Blue-Smoke-Electronics/Ember/README.md

# Ember, a Portable "Bench top" Power supply

Go to [the wiki](https://github.com/simenhs/Blue_Smoke_Portable_benchtop_supply/wiki) for documentation
