Blue-Smoke-Electronics/Ember/encosure/accessories/Cover.stl

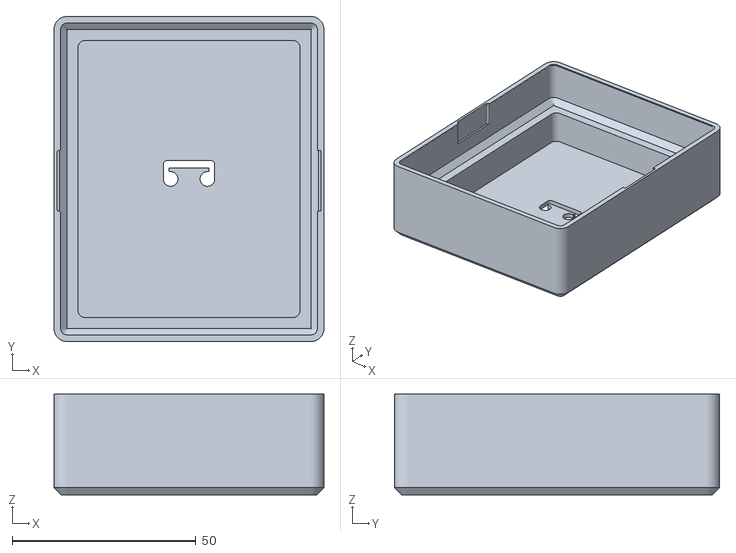
[picture p1: CAD file, 2023-03-30]
encosure/accessories/Cover.stl
73.5 x 88.5 x 27.5
