Blue-Smoke-Electronics/Ember/encosure/Frontpanel_no_ears.stl

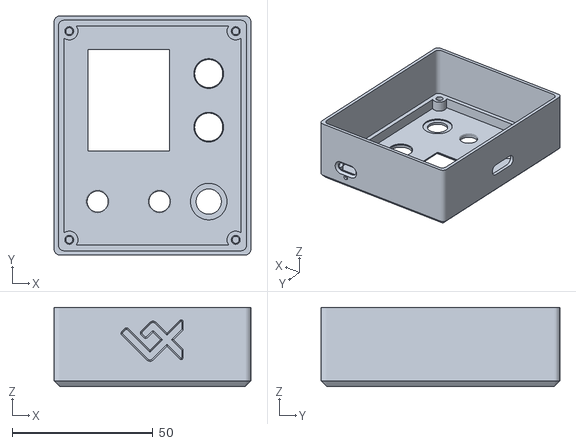
[picture p2: CAD file, 2023-10-11]
encosure/Frontpanel_no_ears.stl
70.0 x 85.0 x 28.2
