Blue-Smoke-Electronics/Ember/encosure/accessories/Cover_rev7_8_9.stl

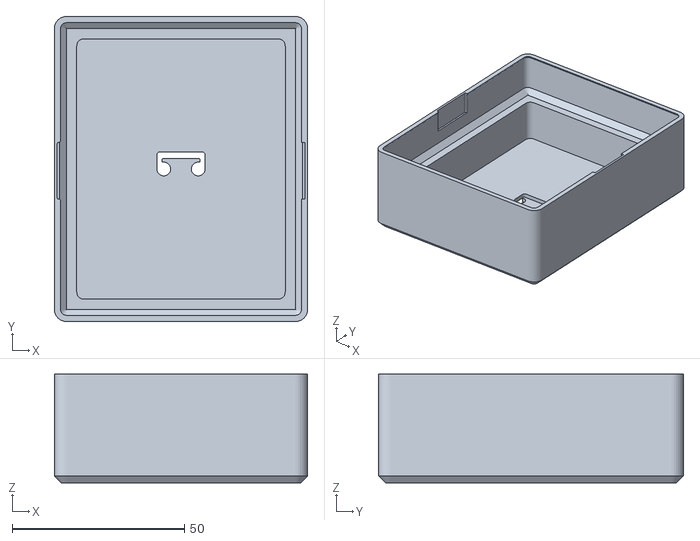
[picture p3: CAD file, 2023-03-30]
encosure/accessories/Cover_rev7_8_9.stl
73.5 x 88.5 x 31.5
