Blue-Smoke-Electronics/Ember/encosure/display_holder.stl

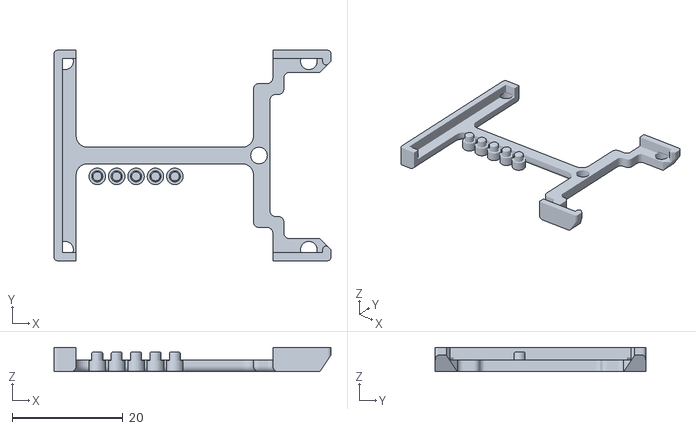
[picture p4: CAD file, 2023-09-27]
encosure/display_holder.stl
50.0 x 38.0 x 4.42
