Blue-Smoke-Electronics/Ember/encosure/Bottom_lid.stl

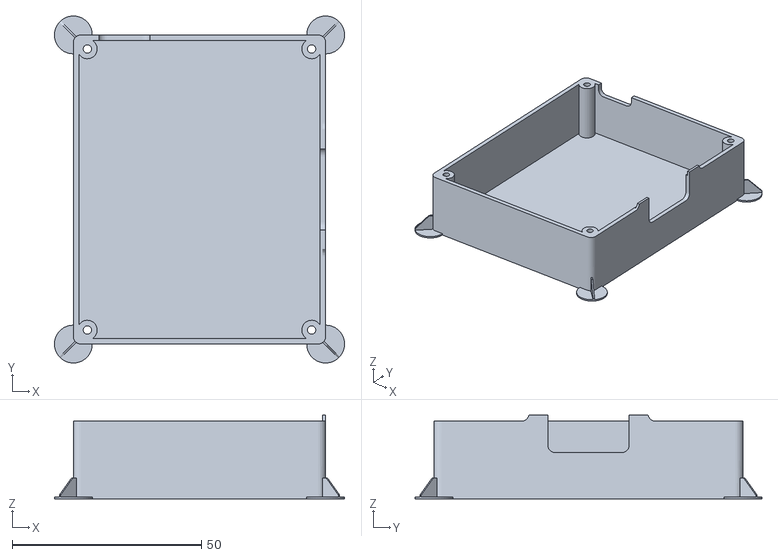
[picture p5: CAD file, 2023-03-14]
encosure/Bottom_lid.stl
76.6 x 91.6 x 22.1
