Blue-Smoke-Electronics/Ember/encosure/encoder_knob_custom.stl

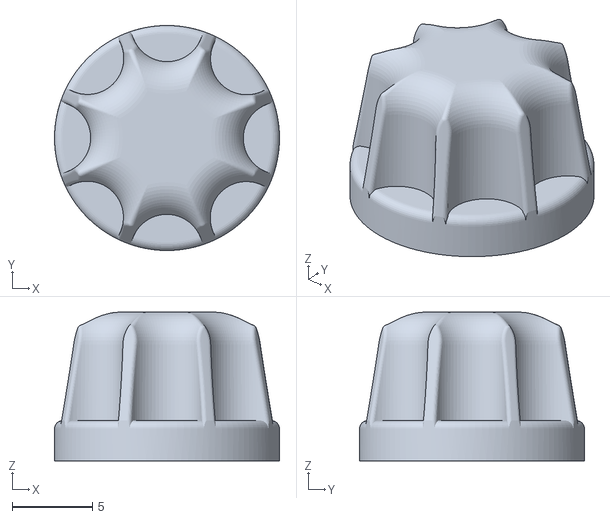
[picture p6: CAD file, 2023-02-27]
encosure/encoder_knob_custom.stl
14.0 x 14.0 x 9.25
