Blue-Smoke-Electronics/Ember/encosure/Frontpanel.stl

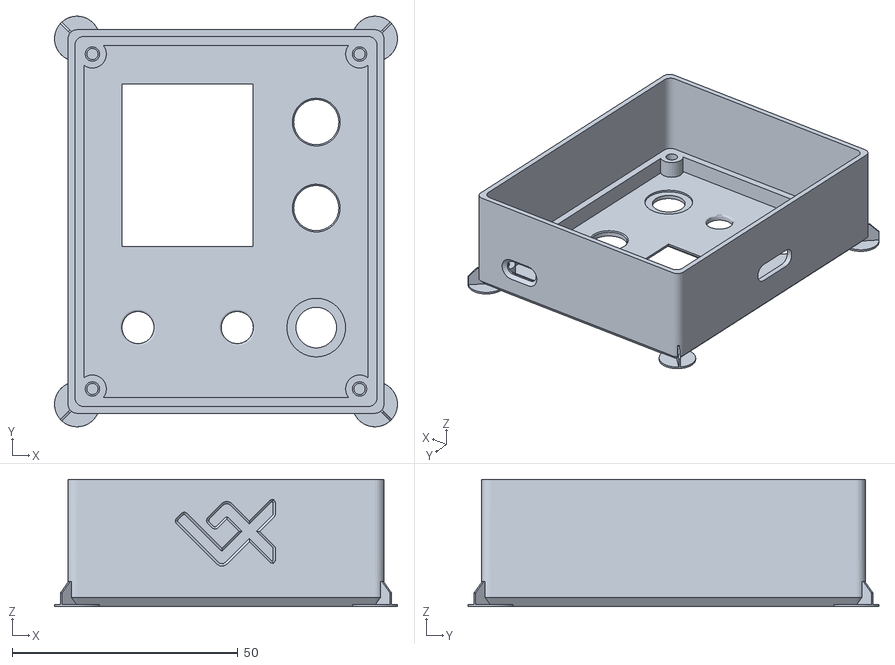
[picture p7: CAD file, 2023-02-19]
encosure/Frontpanel.stl
76.0 x 91.0 x 28.2
