Blue-Smoke-Electronics/Ember/encosure/power_button.stl

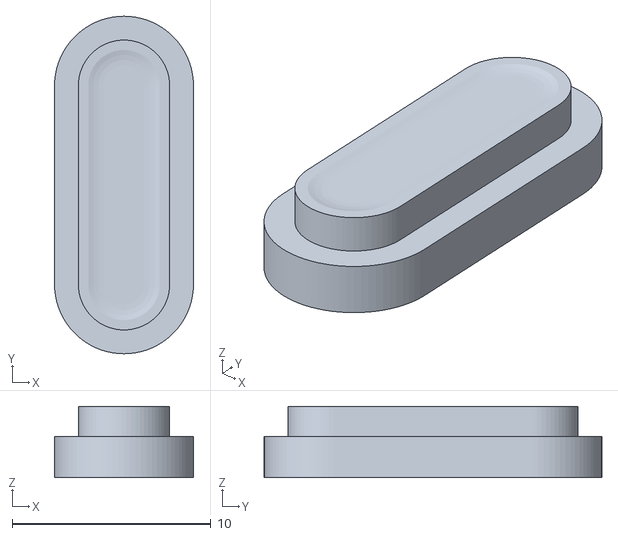
[picture p8: CAD file, 2023-02-14]
encosure/power_button.stl
7.00 x 17.0 x 3.58
