Blue-Smoke-Electronics/Ember/encosure/button_round.stl

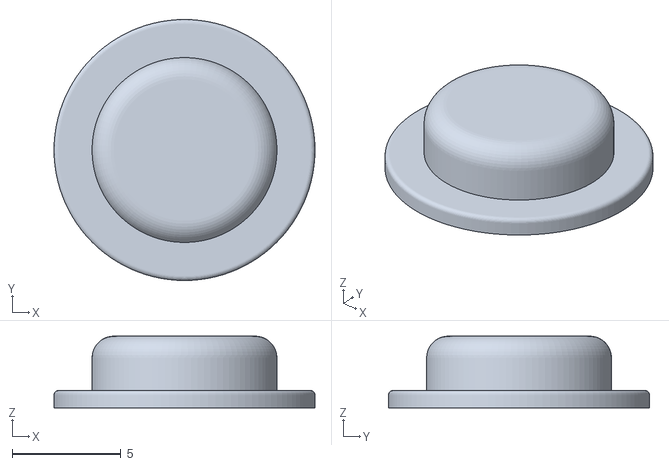
[picture p9: CAD file, 2023-02-14]
encosure/button_round.stl
12.0 x 12.0 x 3.30
