Blue-Smoke-Electronics/Ember/encosure/Bottom_lid_no_ears.stl

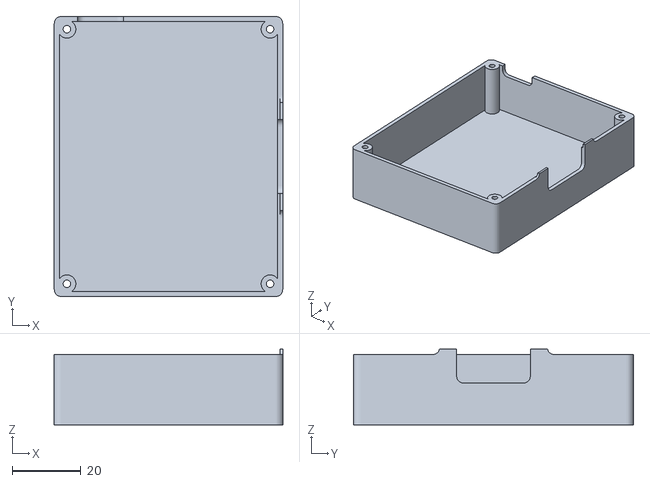
[picture p10: CAD file, 2023-02-14]
encosure/Bottom_lid_no_ears.stl
66.6 x 81.6 x 22.1
