Blue-Smoke-Electronics/Ember/(list of files, cad)

Other CAD files:
encosure/inventor/rev4/lab powersupply.iam
