Blue-Smoke-Electronics/Ember/(threads)

Thread 14 (2022-02-07):

power off battery when battery is empty

simenhs, 2022-02-07:

simenhs, 2022-02-16:
added pmos after batteryes, switch and usb enables power troght mosfet

simenhs, 2022-02-17:
mcu need a way to turn off the unit to save battery form undercharging

simenhs, 2022-02-17:
push button: lover cost, simpler mechanical design, easyer to write software.

slide switch: do already have footprint, has some swithches in stock, has working mechanical designa,

simenhs, 2022-02-21:
using push buttorn

Closed 2022-02-21.

Thread 17 (2022-02-16):

find battery connector

simenhs, 2022-02-16:

simenhs, 2022-02-16:
battery info: 3.7V 20C 380mAh 702035 Lipo lithium polymer rechargeable Battery
For Hubsan H107 H6C RC Quadcopter Helicopters RC Drone Parts

simenhs, 2022-02-16:
XH 2.0mm

simenhs, 2022-02-16:
https://www.digikey.no/en/products/detail/molex/0510050200/379620

simenhs, 2022-02-16:
https://www.alibaba.com/product-detail/Molex-51005-51006-2-pin-female_60863668004.html

simenhs, 2022-02-16:
oredered 10 samples from alibaba

Thread 28 (2022-03-05):

two channals posible?

simenhs, 2022-03-05:

simenhs, 2022-06-17:
I also like the multi channel idea, but it does not need much extra complexity. Implement the multi channel by just using two or more of the same power supplies, and then add some option to put them either in series or parallel. An extra plus if the "slave" channels no not even have an LCD (which is a relatively expensive part) and all channels can be set by the same user interface. For mechanical integration, the units could be made stackable. This would need the banana connectors to be on the side though.
If you have stackable units, then a simplified slave unit could also be just an extra and exchangeable battery pack.

Thread 29 (2022-03-10):

filter Vcontroll pin on lt3080

simenhs, 2022-03-10:

simenhs, 2022-03-10:
24 dB PSRR isn't *good*, but its certainly an improvement not to be sneezed at.   However the [LT3080 datasheet](https://www.analog.com/media/en/technical-documentation/data-sheets/3080fc.pdf) claims its good for over 30dB PSRR at 200kHz (see fig. 'Ripple Rejection, Single Supply' on page 7), and if you split the 'In' and 'Vcontrol' pins and thoroughly passive filter the supply to the latter to reduce its ripple by at least an order of magnitude, you should be able to get nearly 50dB PSRR (See fig. 'Ripple Rejection, Dual Supply, IN Pin' on same page and note the hump near 200KHz).

Closed 2022-06-17.

Thread 32 (2022-03-14):

replace 4.5V charger with 4.2V

simenhs, 2022-03-14:

simenhs, 2022-03-14:
MCP73832T-5 is 4.5V
MCP73832T-2 is 4.2V

simenhs, 2022-03-14:
MCP73831T-2  is avilable
only diffrence is that stat output is high not high-z when charging is compleated
not a problem when not connected to mcu

simenhs, 2022-04-04:
replaced part

Closed 2022-04-04.

Thread 33 (2022-03-14):

battery voltage sens resoults in overvoltage for mcu when not enabled.

simenhs, 2022-03-14:

simenhs, 2022-03-14:
when transistor is turned off. all voltage sens lines is vbat

simenhs, 2022-03-14:
pmos on inputs will solve problem

simenhs, 2022-04-04:
this all got removed when switching to boost mode system

Thread 39 (2022-03-16):

find out why there is a some voltage after on/off p-mos

simenhs, 2022-03-16:

simenhs, 2022-04-07:
messure current draw when device is off to veryfiy that problem is gone

Thread 40 (2022-03-16):

encoder 2.2nF cap- can it be replaced with somting used elsewhere

simenhs, 2022-03-16:

simenhs, 2022-04-06:
replaced with 100nF

Closed 2022-04-06.

Thread 41 (2022-03-16):

to mutch power disipation in dilplay led reistors

simenhs, 2022-03-16:

simenhs, 2022-03-16:
(30-1.7)^2/1000=0.8W

simenhs, 2022-03-16:
3.2V diode drop

simenhs, 2022-03-16:
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

simenhs, 2022-03-16:
changing to 3.3V  and 24 ohm resistor seems to work vell. 2.9V voltage drop, and 17mA current

simenhs, 2022-04-04:
replaced resistors and connected to 3v3

Thread 46 (2022-03-17):

why did the buck die?

simenhs, 2022-03-17:

simenhs, 2022-03-17:
booster worked a fiew minuts. then stopped while testing with load.
resistance set 470 / 2k+4k7 -> 12V output
tested with 1A current draw
cables from load was not attached properly, just hold agenst the inductor utput pin

simenhs, 2022-04-04:
stopped using buck, using booster instead

Closed 2022-04-04.

Thread 50 (2022-03-21):

Is isolation lost wiht current senso on usb? Is optocopler better?

simenhs, 2022-03-21:

simenhs, 2022-03-23:
voltage diffrence between usb gnd and main ground do increase when tuching vin an usbgnd

simenhs, 2022-03-23:
muc died after testing this

Thread 53 (2022-03-23):

replace mcu with respary pi pico (RP2040)

simenhs, 2022-03-23:

simenhs, 2022-04-04:
done

Closed 2022-04-04.

Thread 55 (2022-04-25):

3020-06-0300-00 (programming header) footprint to small pads

simenhs, 2022-04-25:

simenhs, 2022-06-01:
replaced connector with 1.27 mm connector

Closed 2022-06-01.

Thread 59 (2022-04-25):

on/off reisstors is designed for 27V

simenhs, 2022-04-25:

simenhs, 2022-04-26:
replaceing 50k with 2k7

simenhs, 2022-04-26:
also remove r72  10K voldage divider resistor.

simenhs, 2022-05-16:
updated in shematics

Closed 2022-05-20.

Thread 60 (2022-04-26):

linreg limiting voltage to 13.2 wit current resitor setup

simenhs, 2022-04-26:

simenhs, 2022-04-26:
replaceing 3x 10k resistor with 2k7 resistor changes limit to 15.51V

simenhs, 2022-05-16:
updated in shematics

Closed 2022-05-20.

Thread 61 (2022-04-27):

on/off switch needs debounce cap

simenhs, 2022-04-27:

simenhs, 2022-04-27:
100nF after 100k resistor works fine

simenhs, 2022-05-08:
add debounce to encoder and output switch also

simenhs, 2022-05-20:
added to shematics

Closed 2022-05-20.

Thread 63 (2022-05-05):

voltage drop on output when display is drawing

simenhs, 2022-05-05:
Sending data over spi to display leads to a smal voltage drop on 3V3 rail. This is amplefied and leads to voltage drop on ouput

simenhs, 2022-06-05:
does this happen whith

simenhs, 2022-06-05:
incrreasing pwm filtering removes noice, but slows down voltage change speed

simenhs, 2022-06-05:
2 hz filter seeamns nice, updated shematic

Closed 2022-06-05.

Thread 65 (2022-05-09):

battery charging status not connected

simenhs, 2022-05-09:
connect battery charger stat pin to mcu. remember voltage divider 10k + 10k

simenhs, 2022-05-09:
May not be nessesary

simenhs, 2022-05-20:
not used

Closed 2022-05-20.

Thread 68 (2022-05-11):

Display connectr cabele need to be bent

simenhs, 2022-05-11:
move connector to match display cable

simenhs, 2022-06-21:
connector moved

Closed 2022-06-21.

Thread 83 (2022-05-27):

linreg voltage drop is high - 3V

simenhs, 2022-05-27:

simenhs, 2022-05-27:
should be posible to reduce this close 1.35V

simenhs, 2022-05-27:
efficinsy from 06. to 0.7

simenhs, 2022-05-27:
does no solve problem form 0 to 4V output

simenhs, 2022-05-27:
600 mA -> 100C

betther cooling on linreg posible

simenhs, 2022-05-27:
add one paralell linreg and larg cooling plane

Closed 2022-05-27.

Thread 84 (2022-05-27):

try to replace linreg with a mosfet

simenhs, 2022-05-27:

simenhs, 2022-05-27:
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

Thread 90 (2022-06-17):

replace lt3080 with transistor and opamp

simenhs, 2022-06-17:

simenhs, 2022-06-17:
I also do not like the use of the LT3080.
I understand it's sort of attractive because of it's ease of use, but it's too expensive for what it does. It is just a voltage follower.
Combine that with that you've put two of them parallel. This makes it even more expensive, and a "less good fit" for your application.
It also looks like you have a 100mOhm current measurement shunt behind the LT3080 and even an extra schottky diode, and both further reduce the usefulness of the LT3080.

I see you take a feedback voltage directly from the output (R24 and R25) but I do not know where that is going to or what the total control loop is.
I do see three RC combinations on the LT3080 sheet which suggest that it's going to react really slowly to any change of the output voltage or the feedback loop.
Is the final control loop done in software? This would make it even slower.
Using a NPN BJT as a voltage follower and the (already available) opamp to close a control loop around it (and the shunt resistor and schottky diode) seems a better solution to me.

simenhs, 2022-06-20:
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

Thread 92 (2022-06-20):

add 500mA dc/dc converter

simenhs, 2022-06-20:

simenhs, 2022-06-20:
https://www.digikey.no/en/products/detail/recom-power/RPM5-0-1-0/9644693

simenhs, 2022-06-20:
https://www.digikey.no/en/products/detail/mornsun-america-llc/B0505XT-2WR3/16348351

simenhs, 2022-08-30:
skipping isolated usb. recomeding external usb - usb isolator when isolation is needed

Closed 2022-08-30.

Thread 100 (2022-07-03):

proto 160x128 display

simenhs, 2022-07-03:

simenhs, 2022-08-30:
display mounted on pcb with smal wires. new software writen. Smaller display is big enoght for esential information

Closed 2022-08-30.

Thread 101 (2022-07-03):

cleanup git repo

simenhs, 2022-07-03:

simenhs, 2022-07-03:
only have code, shematic pdf, .stl files and gerbers in public branche

simenhs, 2022-08-30:
git repo cleaned up

Closed 2022-08-30.

Thread 103 (2022-07-05):

display bug when holding in power on button

simenhs, 2022-07-05:

simenhs, 2022-07-07:
running flash_erase when from inside IRS is not safe

Closed 2022-07-07.

Thread 105 (2022-07-06):

current do not drop below 65mA

simenhs, 2022-07-06:

simenhs, 2022-07-06:
think it is due to bias current
trying to decrease filter resistors

simenhs, 2022-07-06:
changed back to 10k

simenhs, 2022-09-05:
updated shematic

Closed 2022-09-05.

Thread 106 (2022-07-06):

display bug

simenhs, 2022-07-06:

simenhs, 2022-07-06:
display shift left and right

simenhs, 2022-07-06:
started when testing max power draw- heat may be a issue

simenhs, 2022-07-06:
stopped when display cooled down

simenhs, 2022-07-06:
start happening again when heating display with airgun

simenhs, 2022-08-30:
128x160 display do not have this problem.

Closed 2022-08-30.

Thread 110 (2022-08-11):

saving to flash causes crashes

simenhs, 2022-08-11:

simenhs, 2022-08-17:
100ms delay before writing to eprom (outside interrupt disable region) seams to help

Closed 2022-08-30.

Thread 120 (2022-09-23):

ouput led not working

simenhs, 2022-09-23:

simenhs, 2022-09-23:
led was the wrong way

Closed 2022-09-23.

Thread 128 (2022-10-06):

output + and - marker on silk is wrong

simenhs, 2022-10-06:

simenhs, 2022-10-06:
the markers is right, + and - termanals need to be switched

simenhs, 2022-10-06:
add marker on front side aswell

simenhs, 2022-11-22:
flipped connectors

Closed 2022-11-22.

Thread 140 (2022-10-21):

0V is 0.12V

simenhs, 2022-10-21:

simenhs, 2022-10-21:
fixed it by subtracting 12 adc values from adc reading

Closed 2022-10-21.

Thread 141 (2022-10-21):

voltage occilates at 12V 47mA 211.12ohm

simenhs, 2022-10-21:

simenhs, 2022-10-24:
caused by unstable software regulatoion of current. Reduced maximum current compensation to 20mA

Closed 2022-10-24.

Thread 142 (2022-10-24):

rs232 works when in charging mode

simenhs, 2022-10-24:

simenhs, 2022-10-28:
This is a feature, not a bug

Closed 2022-10-28.

Thread 143 (2022-10-25):

battery last only 6 min, estimated 15

simenhs, 2022-10-25:

simenhs, 2022-10-25:
9 min with fully charged batteryes @ 15W

simenhs, 2022-11-07:
found bug in battery estimation. used W and not mW for booster loses calculation

Thread 145 (2022-10-28):

When charger is unpluged in charging mode, the charging state is not saved to eprom

simenhs, 2022-10-28:

simenhs, 2022-10-28:
fixed

Closed 2022-10-28.

Thread 147 (2022-11-04):

encoder skips values when turned conterclockwise

simenhs, 2022-11-04:

simenhs, 2022-11-04:
Fixed in software. Problem was do to debounce on first falling edge, second seems clean so using that instead.

Closed 2022-11-04.

Thread 150 (2022-11-17):

using pbp to power other pbp with usb only, no battery, do not work

simenhs, 2022-11-17:

simenhs, 2023-02-09:
Could not reproduce with rev 10

Closed 2023-02-09.

Thread 155 (2022-11-22):

battery screw is not accessible when display is mounted.

simenhs, 2022-11-22:

simenhs, 2022-11-22:
Is not a big issue, living it as is.

Closed 2022-11-22.

Thread 157 (2022-11-24):

battery setting: max charge, min charge, shutoff

jerabaul29, 2022-11-24:
There is nothing more frustrating than battery powered devices that work just fine but contain a "nearly dead" battery, which means that i) the device does not work well any longer as there is no more battery life, ii) this creates a fire risk.

A solution for this, in particular with modern rechargeable Li batteries, is to avoid applying full charge or depletion of the battery. (for example, on laptops, see https://linrunner.de/tlp/faq/battery.html ; by using this kind of techniques, I have 10 years old laptops that still have a perfectly working battery).

Would it be possible to provide similar setups in this case? I.e. make it possible to:

- protection 1: limit max charge % of the battery (reasonable default is 70%)
- protection 2: only start charging the battery when its level falls under a given % (typically, only charge the battery when it falls under 60%)
- protection 3: shut down the instrument if battery falls under a given % (typically, 30%)
- activate / deactivate protection, and or change the threshold values of protection 1, 2, 3, by sending a command over USB or some kind of menu with the buttons available.

This would be very helpful for users like me who will likely nearly always use it with a USB supply plugged in, and for whom the battery is only used as a buffer for power spikes.

simenhs, 2022-11-24:
I agree, it is really frustrating when the battery of a device degrades and the device become unusable.  And sadly, batteries has a large but limited number of charging cycles.

You are right, this this would be a great feature to have.

As of now, the charging is done dedicated charging IC (MCP73832T-2ACI/OT) which is charging the battery to 4.2V, that is usually a good tradeoff between battery lifetime and maximum charge. There is no software control of the charging process As for the lower limit, it is implemented in software ( battery.cpp line 58-65).

I have also tried to make the battery as easy as possible to replace. I am using a battery that is quite common in small RC drones (1 cell 803465 lipo).

Thank you very much for your feedback. I will have this in mind going forward.

jerabaul29, 2022-11-24:
Thanks :) . Great to hear confirmation that there is a dedicated IC for managing the battery (I had seen it too in the schematics :) ). What could always be done is add a MOSFET to switch on / off the power supply to the dedicated charging IC and hence the battery, and a MOSFET to switch on / off the power extraction from the IC to the instrument maybe? Not sure if it would be best to have the MOSFET(s) between the battery and the IC (that may prevent the IC from really doing its work well), or between the IC and the rest of the instrument (this way if you trust that the IC assembled correctly prevents any dangerous charge and discharge of the battery, you do not middle in its protection of the battery, but still can decide to charge / discharge or not the battery).

jerabaul29, 2022-11-24:
(and some of these batteries are equipped with protection electronics of their own).

simenhs, 2022-11-24:
Thank you very much for those links. I have been looking for a small battery that can deliver 10A+. It is also awesome that they seem to be coming in a package that should fit in a standard holder. Would be easier to replace and assemble.

I could put a transistor between the battery and the IC. This is not ideal, because when the battery is being discharged there will be a Rdson voltage drop across the transistor. If i put a transistor before the charger, it will also cut off the power from the usb to the device when cutting off charging. The device should run directly from the 5V when the battery is not needed to avoid unnecessary charge/discharge cycles.

jerabaul29, 2022-11-24:
My 2 cents (but I may be wrong) is that it will be challenging to find a small (ie low capacity C) battery that can provide relatively high intensity:

- a small battery will have a quite high internal resistance, so if you draw 10A from it and it has a 0-load voltage of 4V for example, you may end up with quite a lot less voltage across it when drawing 10A
- usually a battery with capacity C should not operate higher in intensity than a given number of C (in some old batteries I was using, for example 5C or 10C; things may be better now though). That may limit how much intensity you may draw from a small battery without damaging it (and damage = fire risk with the newer Li batteries...)

jerabaul29, 2022-11-24:
PS: jeg liker navnet Blue Smoke Electronics, den var gøy 👍

simenhs, 2022-11-26:
Yeah, I know. The battery I am using now has a very high C rating, 25C, and with a 2500mAh rating it should in teori be able to deliver 62.5 A safely. In practice though, the battery is closer to 1600 mAh when tested, and the voltage drop at 10A is still from 4.1V to 3.3V. When drained the battery drops slowly from 3.3V to 3.0V before it is empty and the voltage starts to plummet.
I have ordered one of the batteries you linked that is rated for 10A so i can test it out. To bee honest, I expect the voltage drop to be to high, but it is worth a try. After all, the battery producer seems more serious and maybe a 10A rating actually means that the battery can be used at 10A without a too large voltage drop.

PS: Tusen takk! Setter veldig pris på tilbakemeldinger og gode ideer. Hvordan fant du prosjektet mitt?

jerabaul29, 2022-11-26:
Tindie :) . https://www.tindie.com/products/simenhs/ember-prototype/

Thread 158 (2022-11-24):

removable battery and capacitor instead

jerabaul29, 2022-11-24:
I would like to avoid having more lithium batteries home - these batteries, when getting discharged low enough, are a fire hazard. Would it be possible then to:

- make the battery easily removable, with a battery holder or something like this, and selling the unit optionally with or without battery
- add (a couple of, depending on what voltage is needed) supercapacitor(s) or lithium ion capacitor(s), so that it remains possible to use the unit with some power bursts even without the battery inserted (note: supercapacitors may be best to use, as it is fine to discharge them down to 0; if using lithium ion capacitors, these are like small batteries on some aspects and cannot be drained to 0V, so monitoring of their voltage would be necessary)

simenhs, 2022-11-24:
To remove the battery, you need to screw out 4 screws and disconnect one JST connector, so it is possible to remove/replace the battery.

I really like your idea of using super capacitors. It would be nice to not have to deal with batteries, and all of their drawbacks. I have never really played around with super caps, do you have any experience? Will it be possible to fit them inside the enclosure? I guess I will have to settle for a smaller capacity, but a big reason that I am not using a smaller battery is because of voltage drop over the internal series resistance, and that would not be a problem with supercap.

jerabaul29, 2022-11-24:
I do have played around with super capacitors (supercaps) quite a bit. I have not played with lithium ion capacitors (LICs) too much. I think anyways that, for your kind of application (taking away spikes), supercaps are much easier to use than LICs because it is not an issue if their voltage goes to 0 as long as the voltage impose does not becomes negative.

My 2 cents on supercaps:

- they can be really powerful; I have used some 60F supercaps in parallel to take off power spikes in a linear actuator - something like 10 supercaps in series to get the 25V voltage I needed, it was super effective
- I have not had issues in handling them
- they are not sooo big (you can find some quite small supercaps with 10 or 20 or 30 F capacity; this is really a lot, can easily power electronics in case there is a small spike of a few amps for a few seconds: dU / dt = I / C, so at 10 A and 15F, you loose 0.6V per second!
- they are a bit slower than typical electrolytic caps; so if you want something really neat, may be a good idea to have (for a 5V supply) 2 supercaps in series, in parallel of 2 electrolythic caps in series (possibly in parallel to a few ceramic caps if you want to take out real fast voltage fluctuations).

simenhs, 2022-11-24:
Just some calculations:
When at 100 % output i draw
15V*1A =15W and have around 5W of internal losses -> 20W total power consumption from battery.
I want this last be able to deliver this for atleast 1 min
20W * 60s = 1200 J
min V for device to work - 2.5V  supercap max voltage 2.7V
5000 F -> 5000/2*2.7*2.7 = 1350 J    5000/2*2.5*2.5 = 1200 J   13500-12000 = 1500J
5000 F is around 150 usd

LIC caps
can go up to 3.8V which means i can use a 400 F cap. price: 20 usd (2x220F)

With two super caps in series should be good, I can charge them to 5V and use 75% of their power before they drop below 2.5V. Two 60 F should give me around 18 seconds of maximum power draw.

Will have to test it out, ordering some supercaps and LICs now.

jerabaul29, 2022-11-24:
A few notes / bainstorming / making myself the devils advocate :) :

- the LIC can only be discharged down to 2.5V or something like this (need to check), so some control electronics are needed to make sure the LIC is not over discharged and damaged if you decide to use LICs

- if we assume users that actively choose to have no battery then they always use a USB input, is it really necessary to hold for 1 min? Maybe just taking away the power spikes (let us say 10s) is enough? Then 2 supercaps may be enough?

simenhs, 2022-11-24:
I do already have the protection in place, batteries can not be discharged below 2.5V as well. So that should not be a problem. Production on the other and will be easier if i do not have to worry about shorting the terminals and draining the capacitor.

18 seconds might be enough in many use cases, I agree. Drawing 15W is not going to happen very often ether( the load need to be 15 ohm exactly). I guess the most probable case when a larger battery will be nice is when you are not connected to 5V, like when you are outside. You could bring a power bank...

How did you deal with balancing when you put many supercaps in series? If one of the capacitors gets charged more than the other the chance of one of them being damaged is large if i am splitting 5V over two capacitors(2.8V+2.2V = blue smoke).

jerabaul29, 2022-11-24:
Sounds good.

I have applied passive balancing using 1 resistor of well chosen value in parallel of each capacitor. There are other methods though for example using an op amp. See for example for explanations:

https://www.we-online.com/catalog/media/o671684v410%20ANP090a_EN.pdf
https://www.maximintegrated.com/en/design/technical-documents/app-notes/7/7552.html
https://www.electronicdesign.com/power-management/whitepaper/21134743/balancing-supercapacitor-stack-voltages

Since you have an external power source with the USB cable and you do not need to be low power, you can take some large safety margin (ie have lower resistance resistors than what is strictly needed so that more balancing current than strictly necessary can flow).

simenhs, 2022-11-26:
Thanks, a joy full read.
I think resistors may be good enough when the USB cable is plugged in, as you say, I am not too worried about wasting power then. But I will have to find a way to disconnect the resistors when the charger is disconnected. I do not want the capacitors to always be drained when you plug in and turn on the device. I guess two small transistors easily can fix that.

simenhs, 2022-12-02:
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

simenhs, 2022-12-02:
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

jerabaul29, 2022-12-02:
Looks excellent!

jerabaul29, 2022-12-02:
So you put diodes to avoid revert polarity and overvoltage by choosing the forward voltage suitably I guess?  Looks good :)

simenhs, 2022-12-02:
Tested with two 100F super capasitors in series today. It worked like well. I got around 30 seconds off max output draw, and around 1 hour of idle time. Using resistors as ballansing do not work, it is way to show with reasonable losses. I will test out zener diodes next. Using the battery charger to charge the supercaps works, kinda, but max 4.1V and slow charge below 3V is not ideal. I have one opamp extra in the quad pac I am not currently using, so I am thinking of using that and creating a constant current charger for the supercaps.

simenhs, 2022-12-02:
yes, the diodes is suppose to be 2.7V zener diodes, to protect the individual cells from overvoltage. I guess the also protect from reverse current, but I really hope that that will never happen.

simenhs, 2022-12-02:
Two 100 F supercaps has almost the same size as the batteries, so it will not impact the size of the device to much.

simenhs, 2022-12-05:
https://www.eevblog.com/forum/projects/battery-or-supercapasitor-in-portable-bench-power-supply/

simenhs, 2023-01-02:
Added holder for 18650 li-ion battery on rev 10.

Closed 2023-01-02.

Thread 160 (2022-12-01):

powersupply don't turn of then in please charge mode

simenhs, 2022-12-01:

simenhs, 2022-12-01:
did enter please charge mode when estimated battery was empty, not actuall battery value. Chaged to use voltage messurment to dertermine when to show please charg screen

Closed 2022-12-01.

Thread 161 (2022-12-01):

booster uses a long time ( multiple seconds to power on) with load.

simenhs, 2022-12-01:

simenhs, 2023-02-09:
this was due to a bad mosfet driver, fixed in rev 10

Closed 2023-02-09.

Thread 163 (2022-12-12):

usb-c charger. What is needed to implement 5V PD?

simenhs, 2022-12-12:

simenhs, 2022-12-12:
https://hackaday.com/2022/12/06/usb-c-introduction-for-hackers/ (edited)

simenhs, 2022-12-12:
adding 2x 5K1 resistors enables communication with apple usb-c power supplies.

simenhs, 2022-12-12:
postfited 5k1 resistor to rev 8-9 pcbs.

Closed 2022-12-16.

Thread 164 (2022-12-12):

Make a jig to place binding post correctly, holes horisontal

simenhs, 2022-12-12:

simenhs, 2023-01-02:
see https://github.com/Blue-Smoke-Electronics/Ember/issues/168

Closed 2023-01-02.

Thread 167 (2022-12-26):

Resistors for USB-PD support

Kagee, 2022-12-26:
Two 5k1 ohm resistors between each CC line and earth will give you 5V@3A from USB-PD-compatible USB-C power supplies. Remember do *not* share the resistor between the two CC lines, as the resistance will be wrong (i.e. like the failure of HW rev 1 of the Rpi 4)

https://hackaday.com/2022/12/06/usb-c-introduction-for-hackers/

Thread 168 (2022-12-26):

Align cable holes for more professional feel and safety

Kagee, 2022-12-26:
The cable holes on the banana holes should be aligned for a more "finished" feel. It would also be best if they were alligned vertically (|), as this will meat that 1. The rightmost cable will not potentially block the enable/disable button, and 2. less chance the cables will short circuit if too long leads are used.

Kagee, 2022-12-26:
Duplicate of/more detailed version of #164

Closed 2023-03-30.

Thread 170 (2022-12-26):

Design and optionally include/sell as a option a cover

Kagee, 2022-12-26:
Some kind of cover that could be cut over the screens and buttons while traveling with the PSU would be nice. This would prevent unintended turning on and damage. While the shipping box can be used for this, a snug-fit top can ver would be better.

simenhs, 2023-03-30:
Try printing this: [https://github.com/Blue-Smoke-Electronics/Ember/blob/rev11/encosure/accessories/Cover_rev7_8_9.stl](url)
I created a small lid that should fit over Ember. It is designed to be hold in place by a rubber band.

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

Thread 171 (2023-01-03):

replace ZXGD3009E6TA with ZXGD3009DYTA

simenhs, 2023-01-03:

simenhs, 2023-01-03:
remember to change footprint

simenhs, 2023-01-25:
need to replace this with mosfet ic

Closed 2023-01-25.

Thread 172 (2023-01-16):

voltage is messured 0.1v to low from 4.4v and up

simenhs, 2023-01-16:

simenhs, 2023-01-16:
adc reading contius steps, oversized step form 499 to 500. this is 1.0V input

simenhs, 2023-01-16:
512-12 = 500. The issue happens at 512 adc reading. There is a now DNL in the adc at 512 of 8.5 which coresponds to what I am seeing. check 1536, 2560 and 3584 as well

simenhs, 2023-01-16:
problem at 1536 as well. The other values is above what I use.

simenhs, 2023-01-16:
added code that ajust the voltage around this values. The powersupply is of by 0.08 v at this points, but not over the entire range. increase adc resolution to improve problem later #173

Closed 2023-01-16.

Thread 174 (2023-01-16):

Differential input voltage is max 2V on opamp.

simenhs, 2023-01-16:

simenhs, 2023-01-16:
adding 2k resistor in series with input terminal on opamps while protect from larger than 10mA current when overvoltage occur.

simenhs, 2023-02-09:
do not seem to be a problem, nothing can deliver more than 10 mA into the opamp inputs

Closed 2023-02-09.

Thread 175 (2023-01-20):

replace MBR12100LPS-TP with SVT10100UB_R2_00001 ( larger footprint)

simenhs, 2023-01-20:

simenhs, 2023-02-09:
updated

Closed 2023-02-09.

Thread 176 (2023-01-27):

only show all 5 battery bars when battery is 100% charged

simenhs, 2023-01-27:

simenhs, 2023-04-13:
battery charging bar fixed
0% zero bars
0-25% one bar
25-50% two bars
50-57% three bars
75-100% four bars
100% five bars

Closed 2023-04-13.

Thread 177 (2023-01-27):

bipolar gate driver ic not working. replace with mosfet driven one

simenhs, 2023-01-27:

simenhs, 2023-02-09:
tested DGD0215WT-7, works much better

simenhs, 2023-02-09:
added to shematic

Closed 2023-02-09.

Thread 179 (2023-02-06):

change 5V to 18V and connect opamp power to 18V

simenhs, 2023-02-06:

simenhs, 2023-02-06:
will be able to reduce voltagedrop ower linreg transistor because booster voltage do not need to be 2V higher that linreg voltage

simenhs, 2023-02-06:
booster transistor and gate drive ran handle 18V

simenhs, 2023-02-09:
15.5V might be enough

simenhs, 2023-02-09:
need 17.5V

simenhs, 2023-02-09:
updated shematic

Closed 2023-02-09.

Thread 183 (2023-02-14):

power button hole is not rightly alligned

simenhs, 2023-02-14:

simenhs, 2023-02-27:
7.2 should be good

simenhs, 2023-05-04:
Can not remember what this was about, I may have changed it without updating this issue

Closed 2023-05-04.

Thread 186 (2023-02-24):

make encoder pads larger to make soldering easyer by hand

simenhs, 2023-02-24:

simenhs, 2023-03-06:
fixed

Closed 2023-03-06.

Thread 188 (2023-02-27):

encoder holes need to be larger - 10mm

simenhs, 2023-02-27:

simenhs, 2023-05-04:
Was it bindding post holes I ment? In that case, they have been updated since this issue was created.

Closed 2023-05-04.

Thread 189 (2023-02-27):

capasity calculation is bad

simenhs, 2023-02-27:

simenhs, 2023-03-30:
slowed down voltage correction of battery estimation

Closed 2023-03-30.

Thread 194 (2023-03-02):

C25334 is not a good 0.1R resistor

simenhs, 2023-03-02:

simenhs, 2023-03-06:
replaced with C309528

Closed 2023-03-06.

Thread 197 (2023-04-20):

add back 10k resistor between 3v3 and flash CS pin

simenhs, 2023-04-20:

simenhs, 2023-04-20:
the cs line is upulled love 400 ns (2.5Mhz) spikes, no pattern

simenhs, 2023-04-28:
trying to replace 1k resitor (r8) with diode

simenhs, 2023-04-28:
with diode the button sens line is clean but the device freezes

simenhs, 2023-04-28:
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

diode in series with resistor seems to be working

simenhs, 2023-04-28:
removed 10k resistor, it's not nessecary

simenhs, 2023-05-04:
added diode to shematic

simenhs, 2023-05-30:
freezes both with and without 10K resistor, removing resisor again

Closed 2023-05-30.

Thread 199 (2023-05-04):

17.5V is not enogut on 18V rail

simenhs, 2023-05-04:

simenhs, 2023-05-04:
replaceing r6 (720R) with 680R changed voltage from 17.5 to 19.5V

simenhs, 2023-05-04:
19.4V fixes problem with voltage not rising to 15V

Closed 2023-06-16.

Thread 200 (2023-05-04):

add smooting filter on messurments in display

simenhs, 2023-05-04:

simenhs, 2023-06-20:
implemented in psu.h, using a leaking integrator

Closed 2023-06-20.

Thread 204 (2023-06-12):

replace eproom with 2mB one

simenhs, 2023-06-12:

simenhs, 2023-06-12:
W25Q16JVSSIQ

simenhs, 2023-06-12:
updated schematic

Closed 2023-06-12.

Thread 207 (2023-06-12):

does battery empty symbol show up?

simenhs, 2023-06-12:

simenhs, 2023-06-30:
no, it doesn't

simenhs, 2023-06-30:
There is no need to show battery empty symbol, 0% indicator on battery shows that it's empty

Closed 2023-06-30.

Thread 208 (2023-06-20):

very short time before poweroff

simenhs, 2023-06-20:

simenhs, 2023-06-20:
changed resistor from 470k to 1m8

Closed 2023-06-20.

Thread 209 (2023-06-30):

charger preconditon prevent battery charging

simenhs, 2023-06-30:

simenhs, 2023-06-30:
When battery voltage drops below 2.8V the charging current is limited to 50 mA. That is less than what is needed to keep the device alive while charging. This means that the battery is beeing drained.

simenhs, 2023-06-30:
holding down the power button for a long time can help recover from this problem, because that turns off the powerdraw allowing the battery to recharge to abow 2.8V

simenhs, 2023-07-04:
added 2 2k resistors so that 4V booster is turned off when the voltage dropps below 3V. Turning off the booster does not stop curerent from flowing throug the booster the voltage is just not boosted

simenhs, 2023-07-06:
using MCP73832T-2DCI/OT instead of MCP73832T-2ACI/OT will disable precharging

Closed 2023-07-07.

Thread 210 (2023-07-04):

high power draw when below 3.1V on battery

simenhs, 2023-07-04:

simenhs, 2023-07-04:
stops happening when disconeting 3V3 regulator. Same happens with different 3v3 regulators

simenhs, 2023-07-04:
cutting power to booster doesn't remove problem

simenhs, 2023-07-04:
sees to be happening when a powerddraw of 300mA from 4.2V supply

simenhs, 2023-07-07:
changing inductor to 1.1A 470nH inductor fixed issue

simenhs, 2023-07-07:
schematic updated

Closed 2023-07-07.

Thread 212 (2023-07-24):

voltage doesn't reach 15V

simenhs, 2023-07-24:

simenhs, 2023-07-24:
mcu was defective. replacing mcu worked

Closed 2023-07-24.

Thread 215 (2023-07-25):

usb disconnects when drawing more than 800 mA

simenhs, 2023-07-25:

simenhs, 2023-07-25:
tests done with 15V

simenhs, 2023-07-25:
moving resitor closer to mcu didn't help

adding capacitance (27,47 and 110pF) didn't help

changing resistor from 24 to 27 ohm didn't help

replacing mcu didn't help

simenhs, 2023-08-02:
disconnecting the large plane connected to V-boost removes issue

simenhs, 2023-08-02:
removing resistor and cap changes reverts error

simenhs, 2023-08-02:
only moving resistors didn't help

simenhs, 2023-08-02:
using 4.2V instead of 18V to drive booster swiching transistor fixes problem.

simenhs, 2023-08-02:
incresed 4.2V to 4.5V and connectd driver to that

simenhs, 2023-08-02:
schematic updated

Closed 2023-08-02.

Thread 217 (2023-08-03):

battery is not charged fast enought when the battery level is below 2.5V

simenhs, 2023-08-03:

simenhs, 2023-08-03:
charging is limited by heat in battery charger. The charger regulate it charging current so that its junction temperature do not exceed 85c

simenhs, 2023-08-03:
disabeling booster circuits greatly reduced power draw

simenhs, 2023-08-03:
can the booter enable pin be connected to mcu?

simenhs, 2023-08-03:
testing using debug led pin connected to enable pins, seems to be working

simenhs, 2023-08-03:
updated schematic and software

Closed 2023-08-03.
