Blue-Smoke-Electronics/Ember/Packaging/box_print.pdf

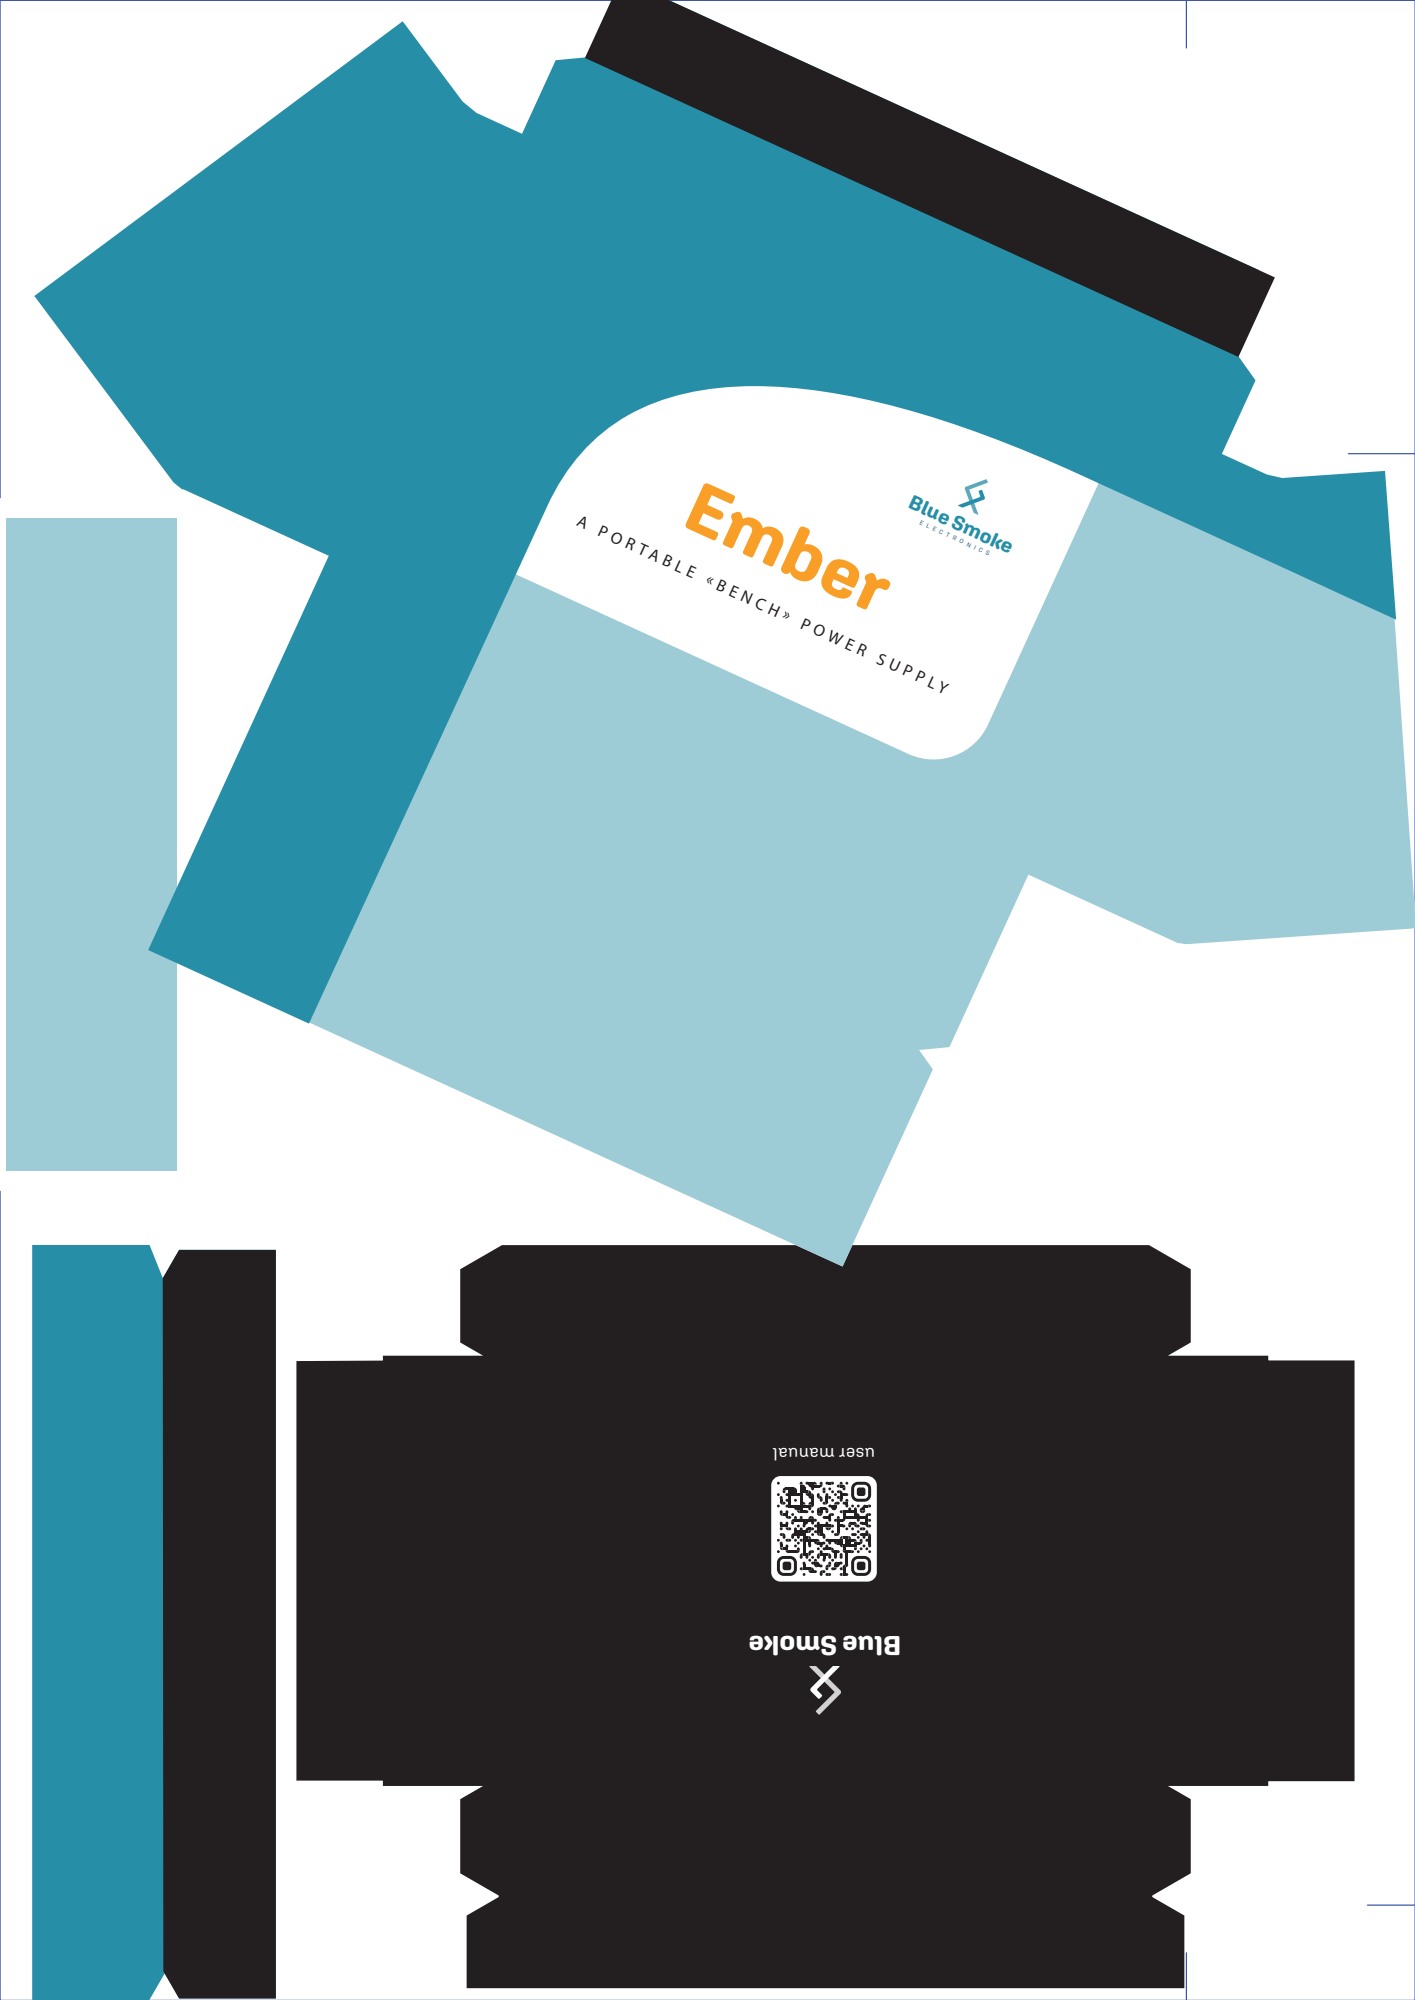
[picture p11: page 1]
Blue Smoke; EL E C T RONI C S; Ember

A PORTABLE «BENCH» POWER SUPPLY
