Blue-Smoke-Electronics/Ember/Packaging/pakaging_drawings.pdf

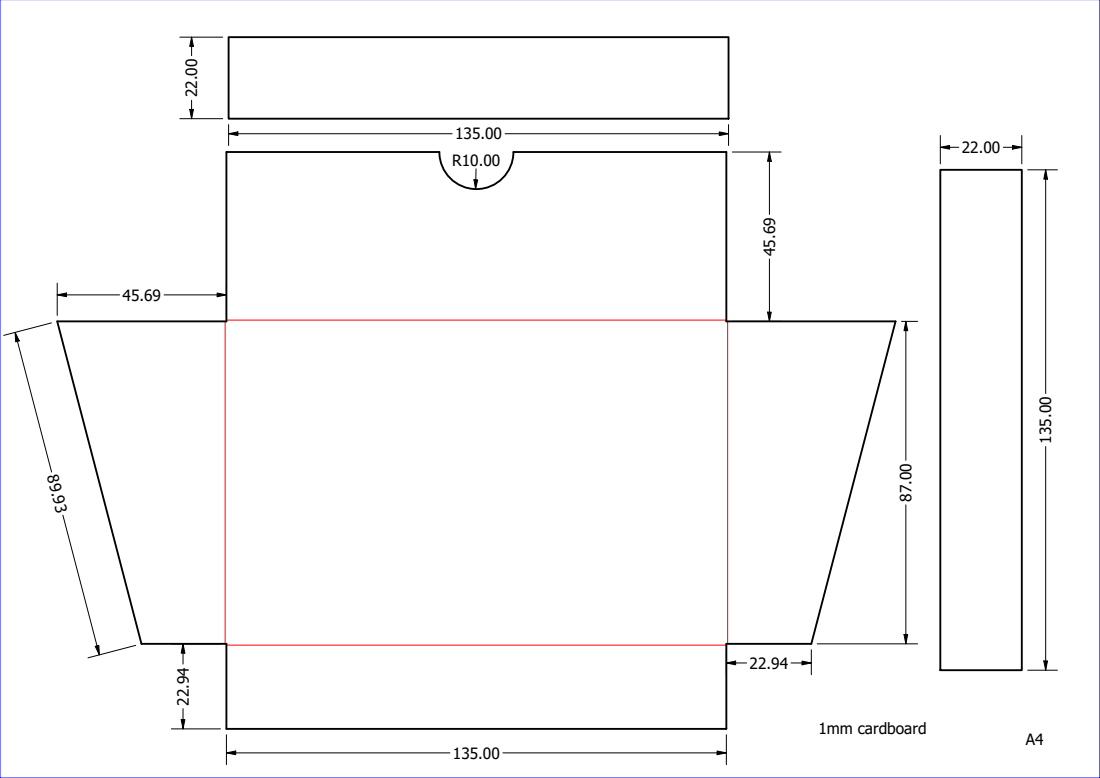
[picture p12: page 1]

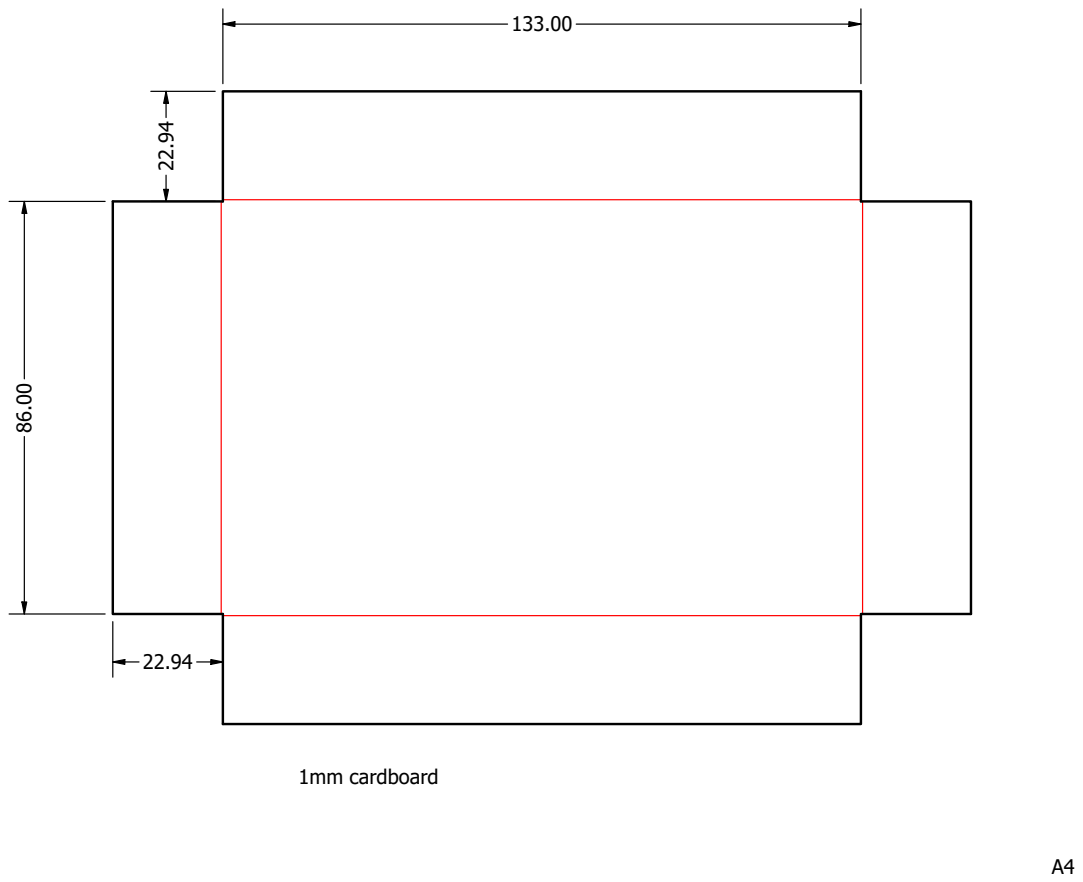
[picture p13: page 2]
1mm cardboard

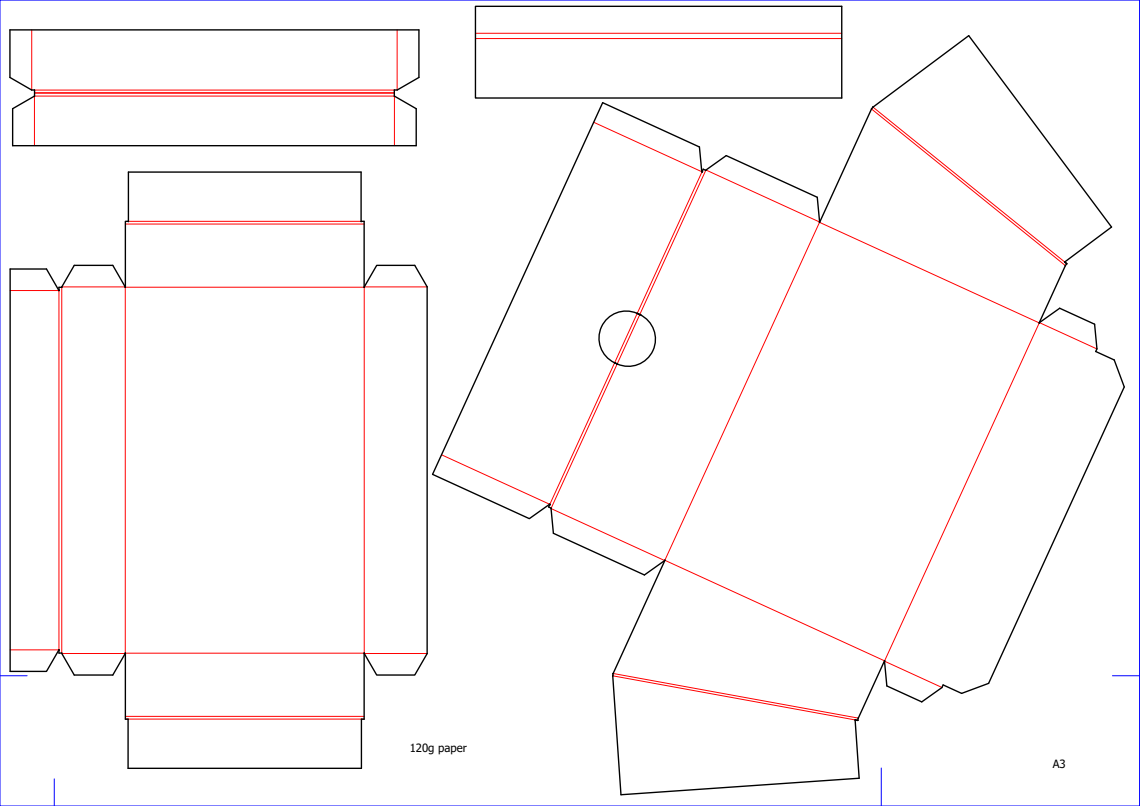
[picture p14: page 3]

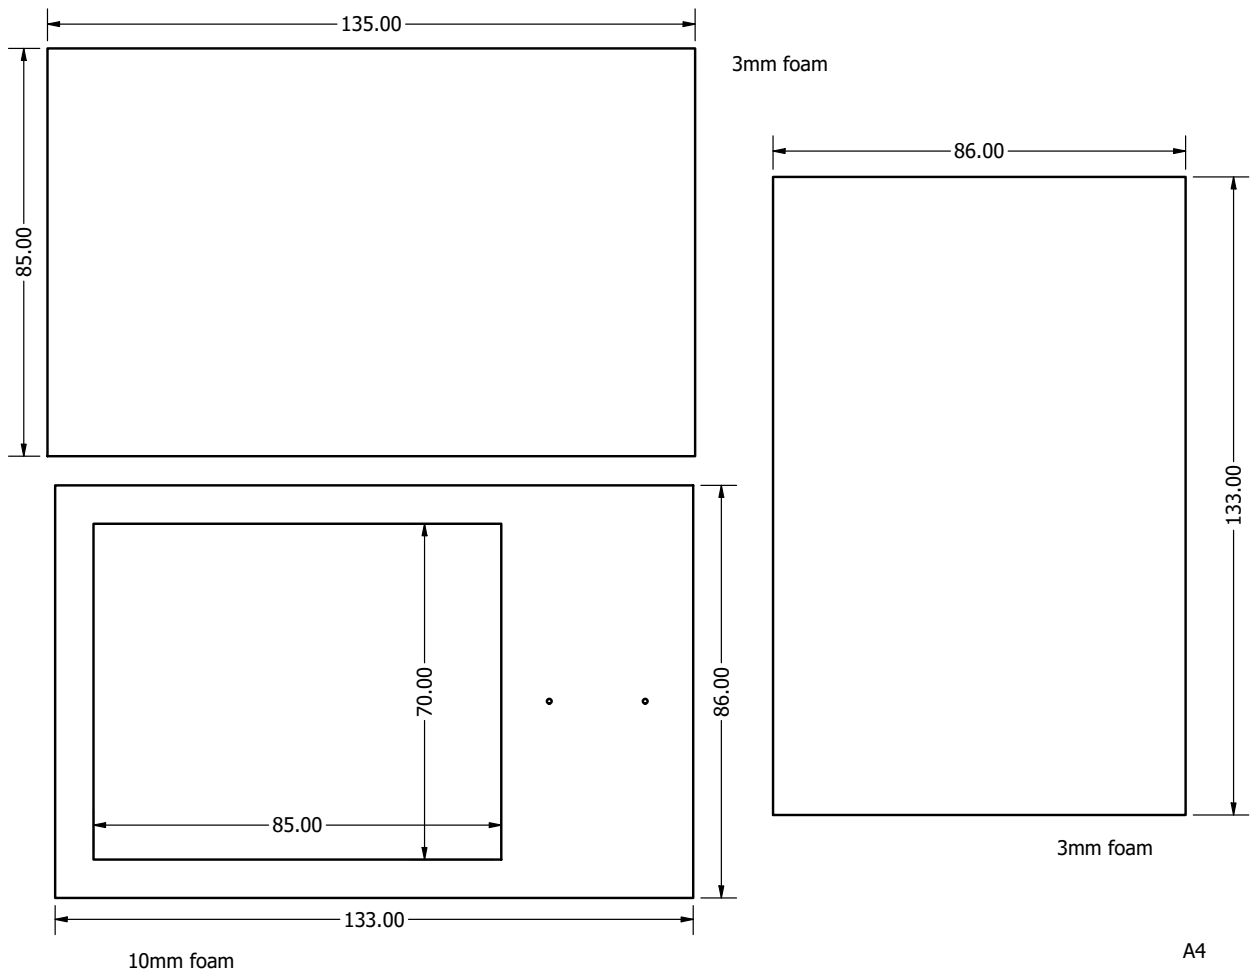
[picture p15: page 4]
10mm foam; 3mm foam
