Blue-Smoke-Electronics/Ember/pcb/Bom/Bindig_post_core.pdf

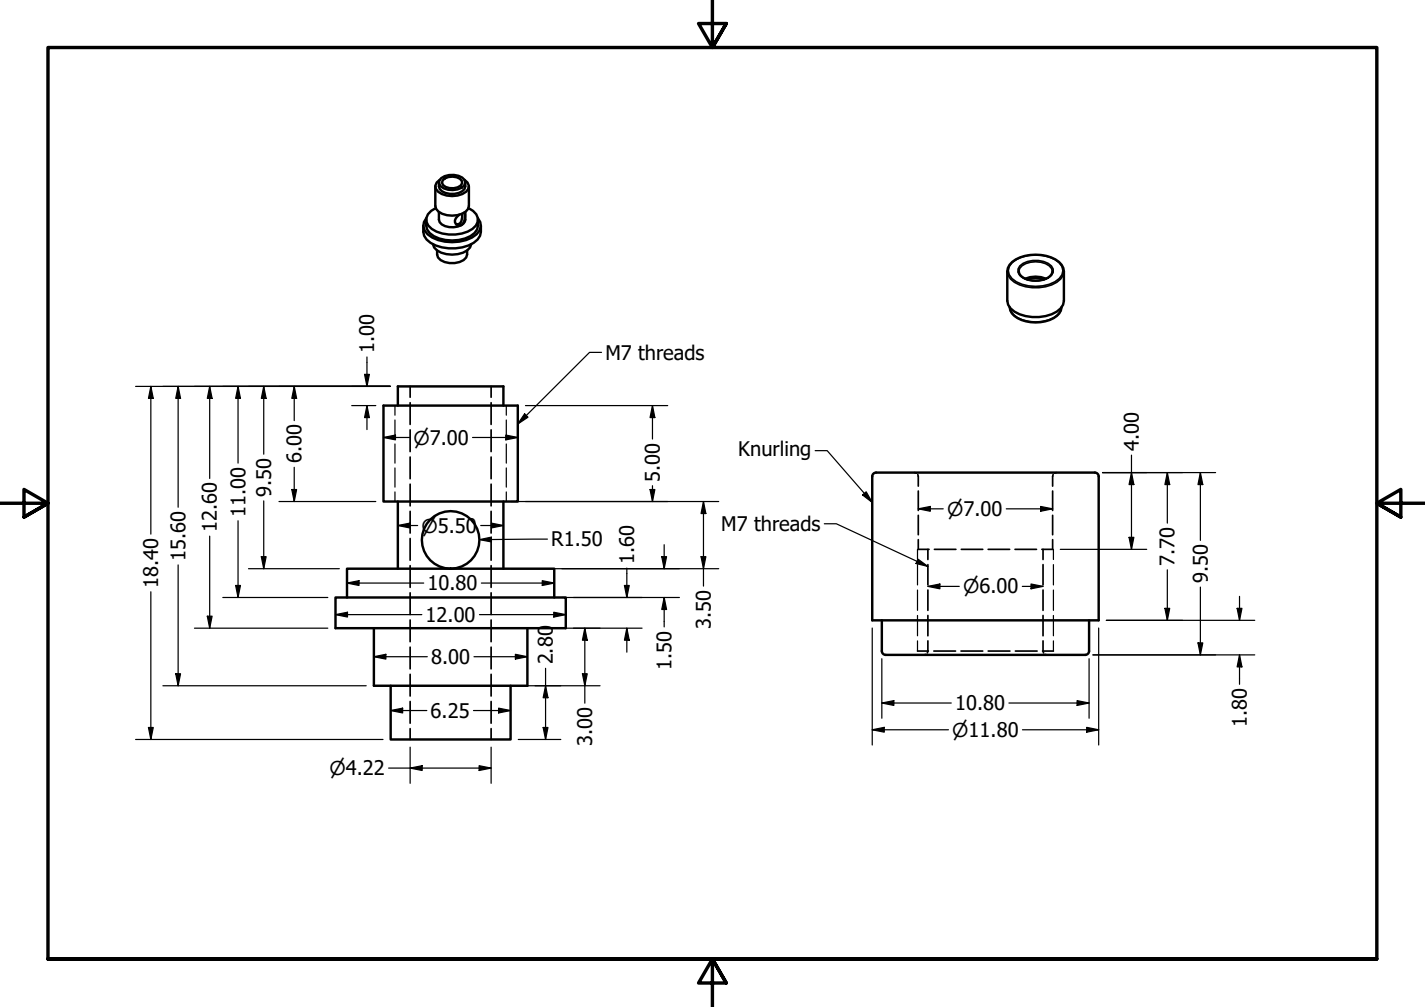
[picture p19: page 1]
