Blue-Smoke-Electronics/Ember/pcb/Schematics/rev_7.pdf

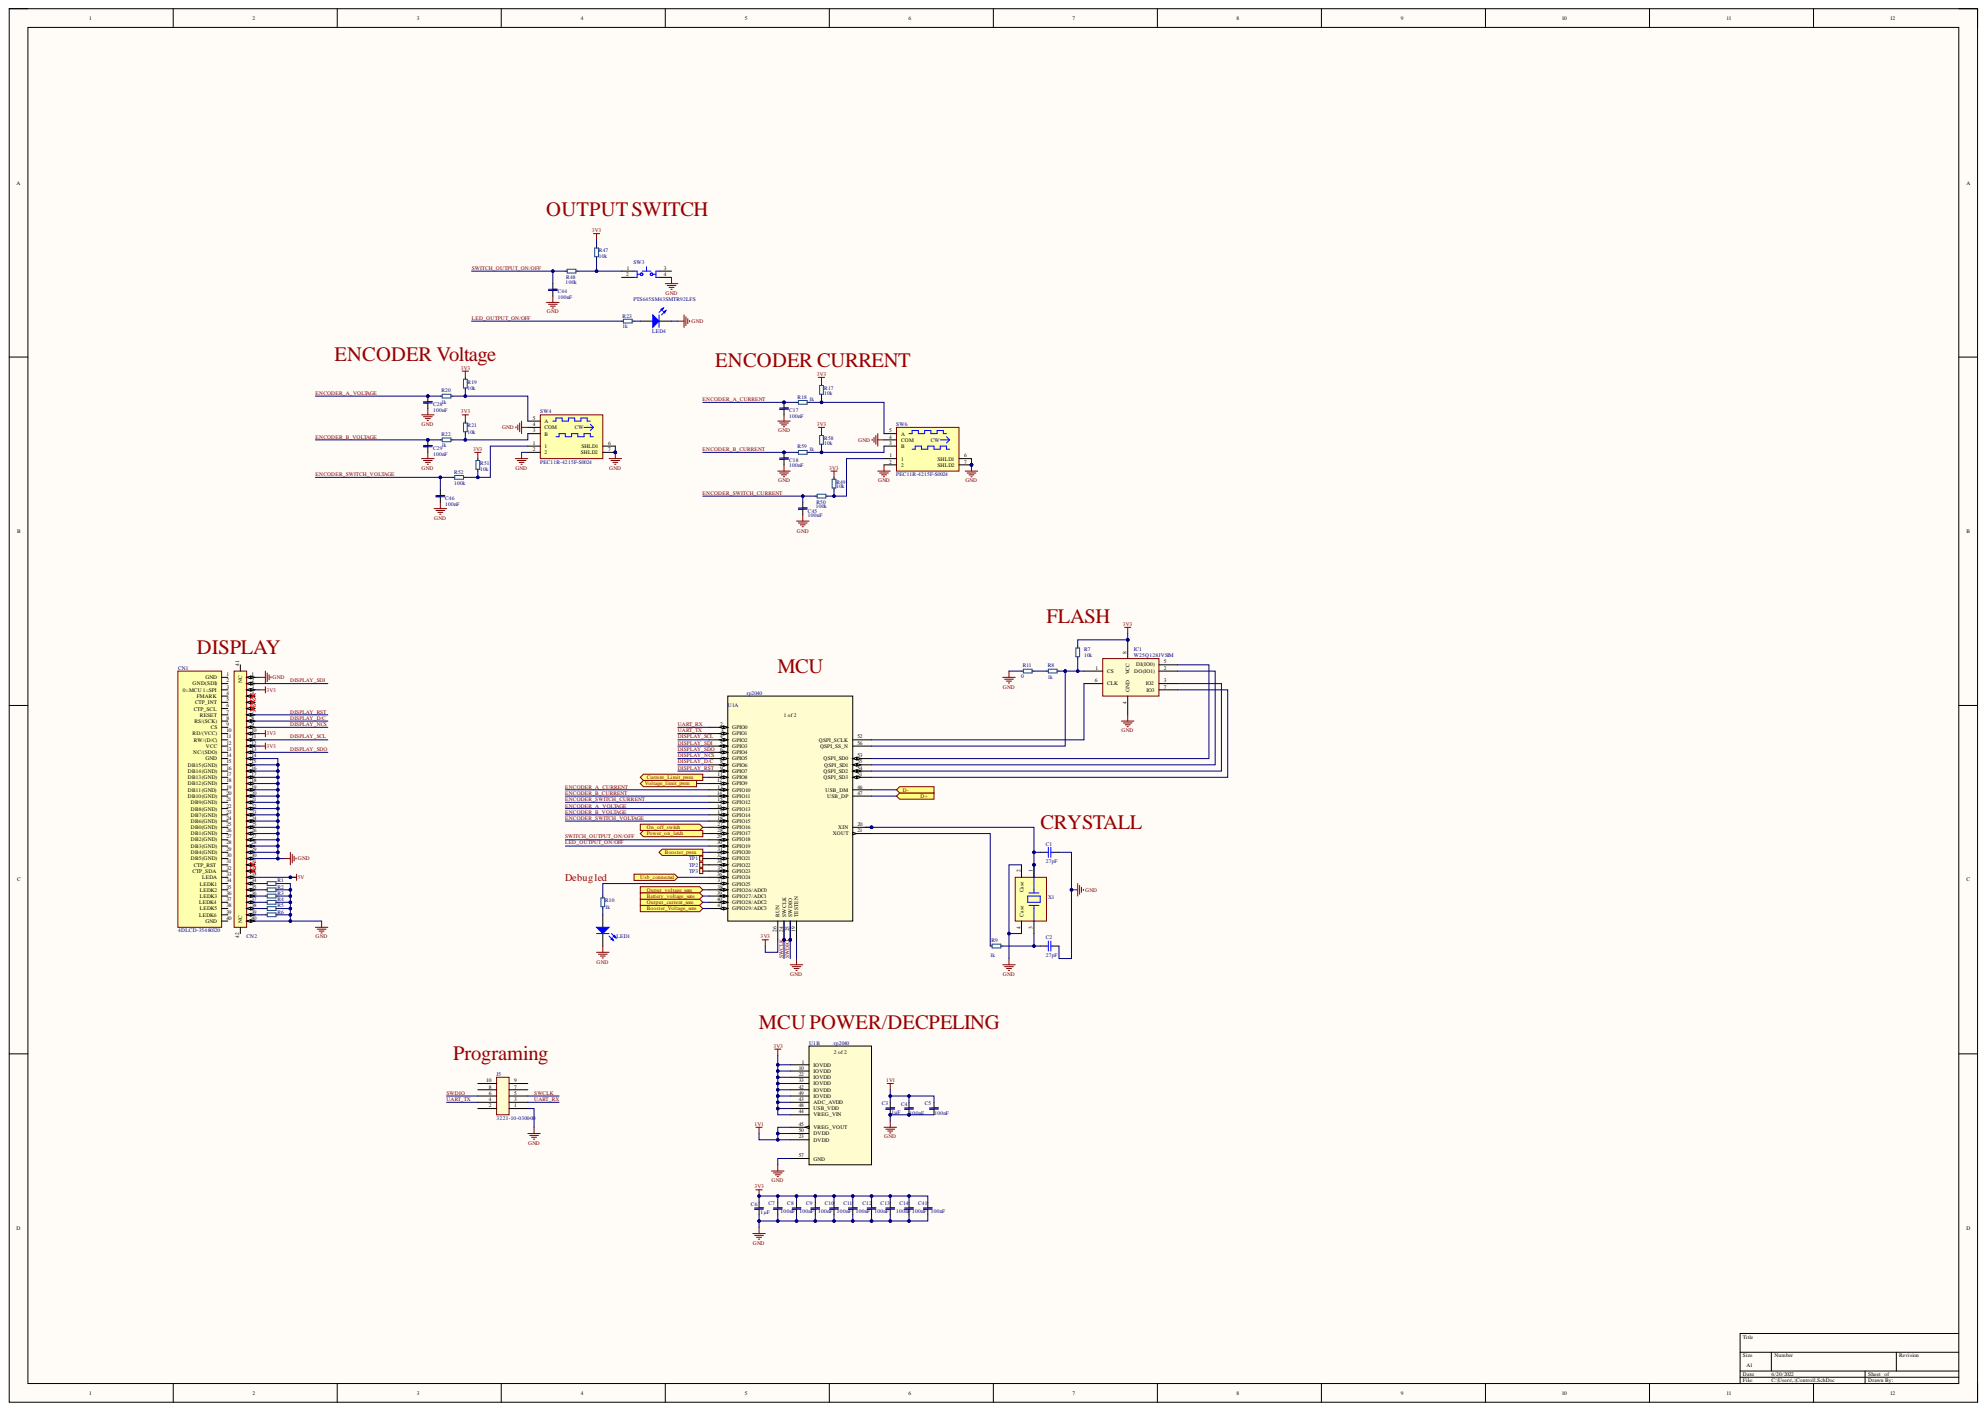
[picture p20: page 1]

0 1k | CS 1 DO(IO1) CLK 6 IO2 | 2 3

GND | | IO3 | 7

IOVDD 49 ADC_AVDD 43

USB_VDD 48 VREG_VIN 44

DVDD 23 DVDD 50

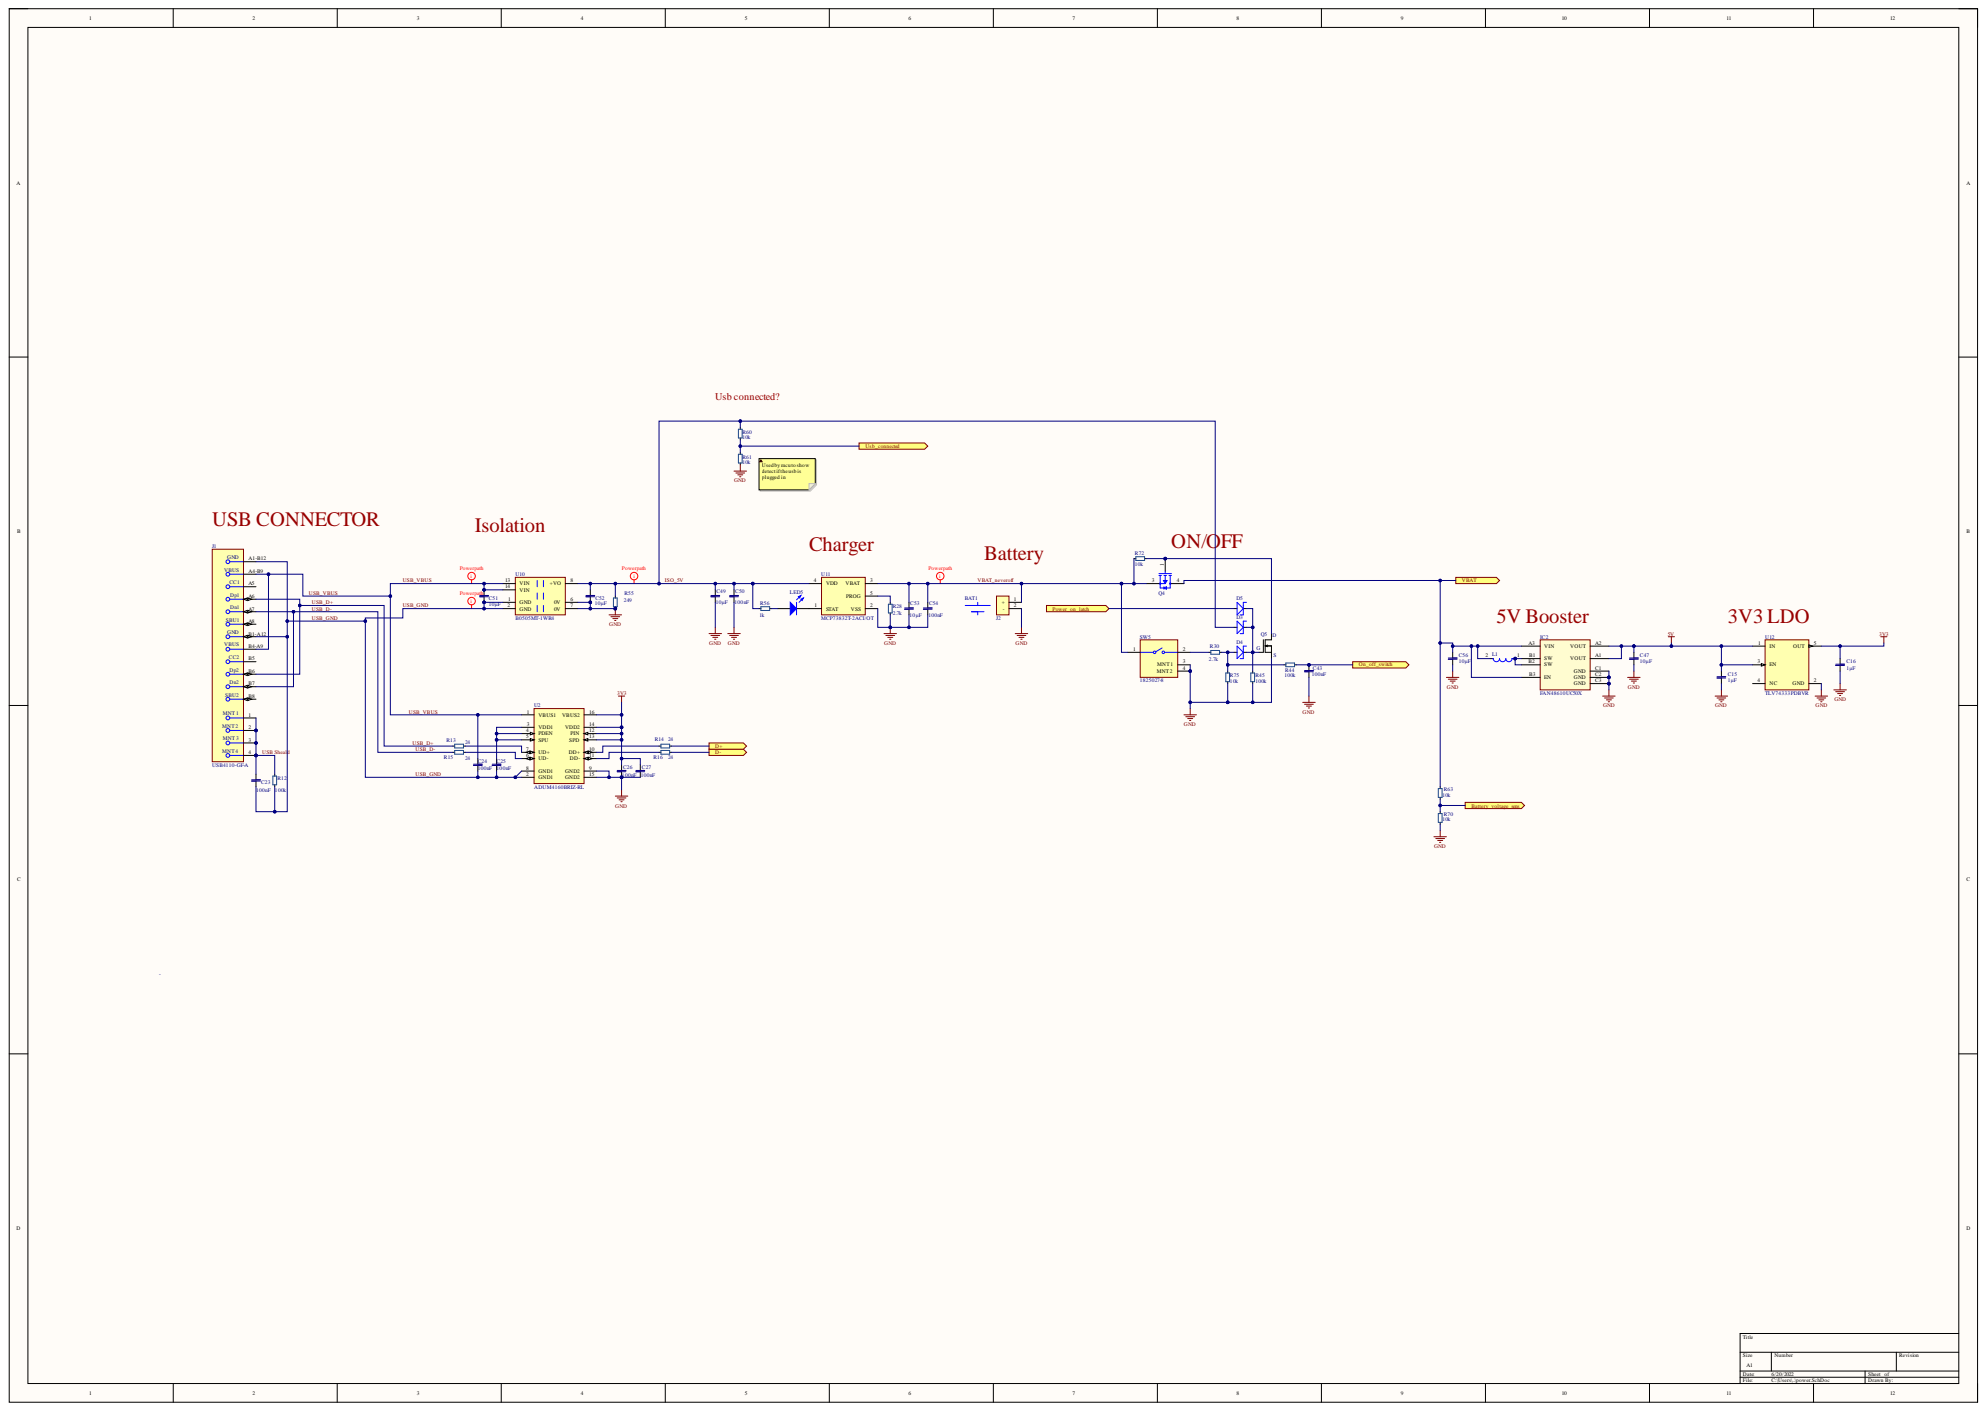
[picture p21: page 2]

USB_ D + | C5 1 i 1 | 0 E D 5 0 0 | 5 2 | 1 R55 +

4 | 1 2
5 8 | 1 3 1 0

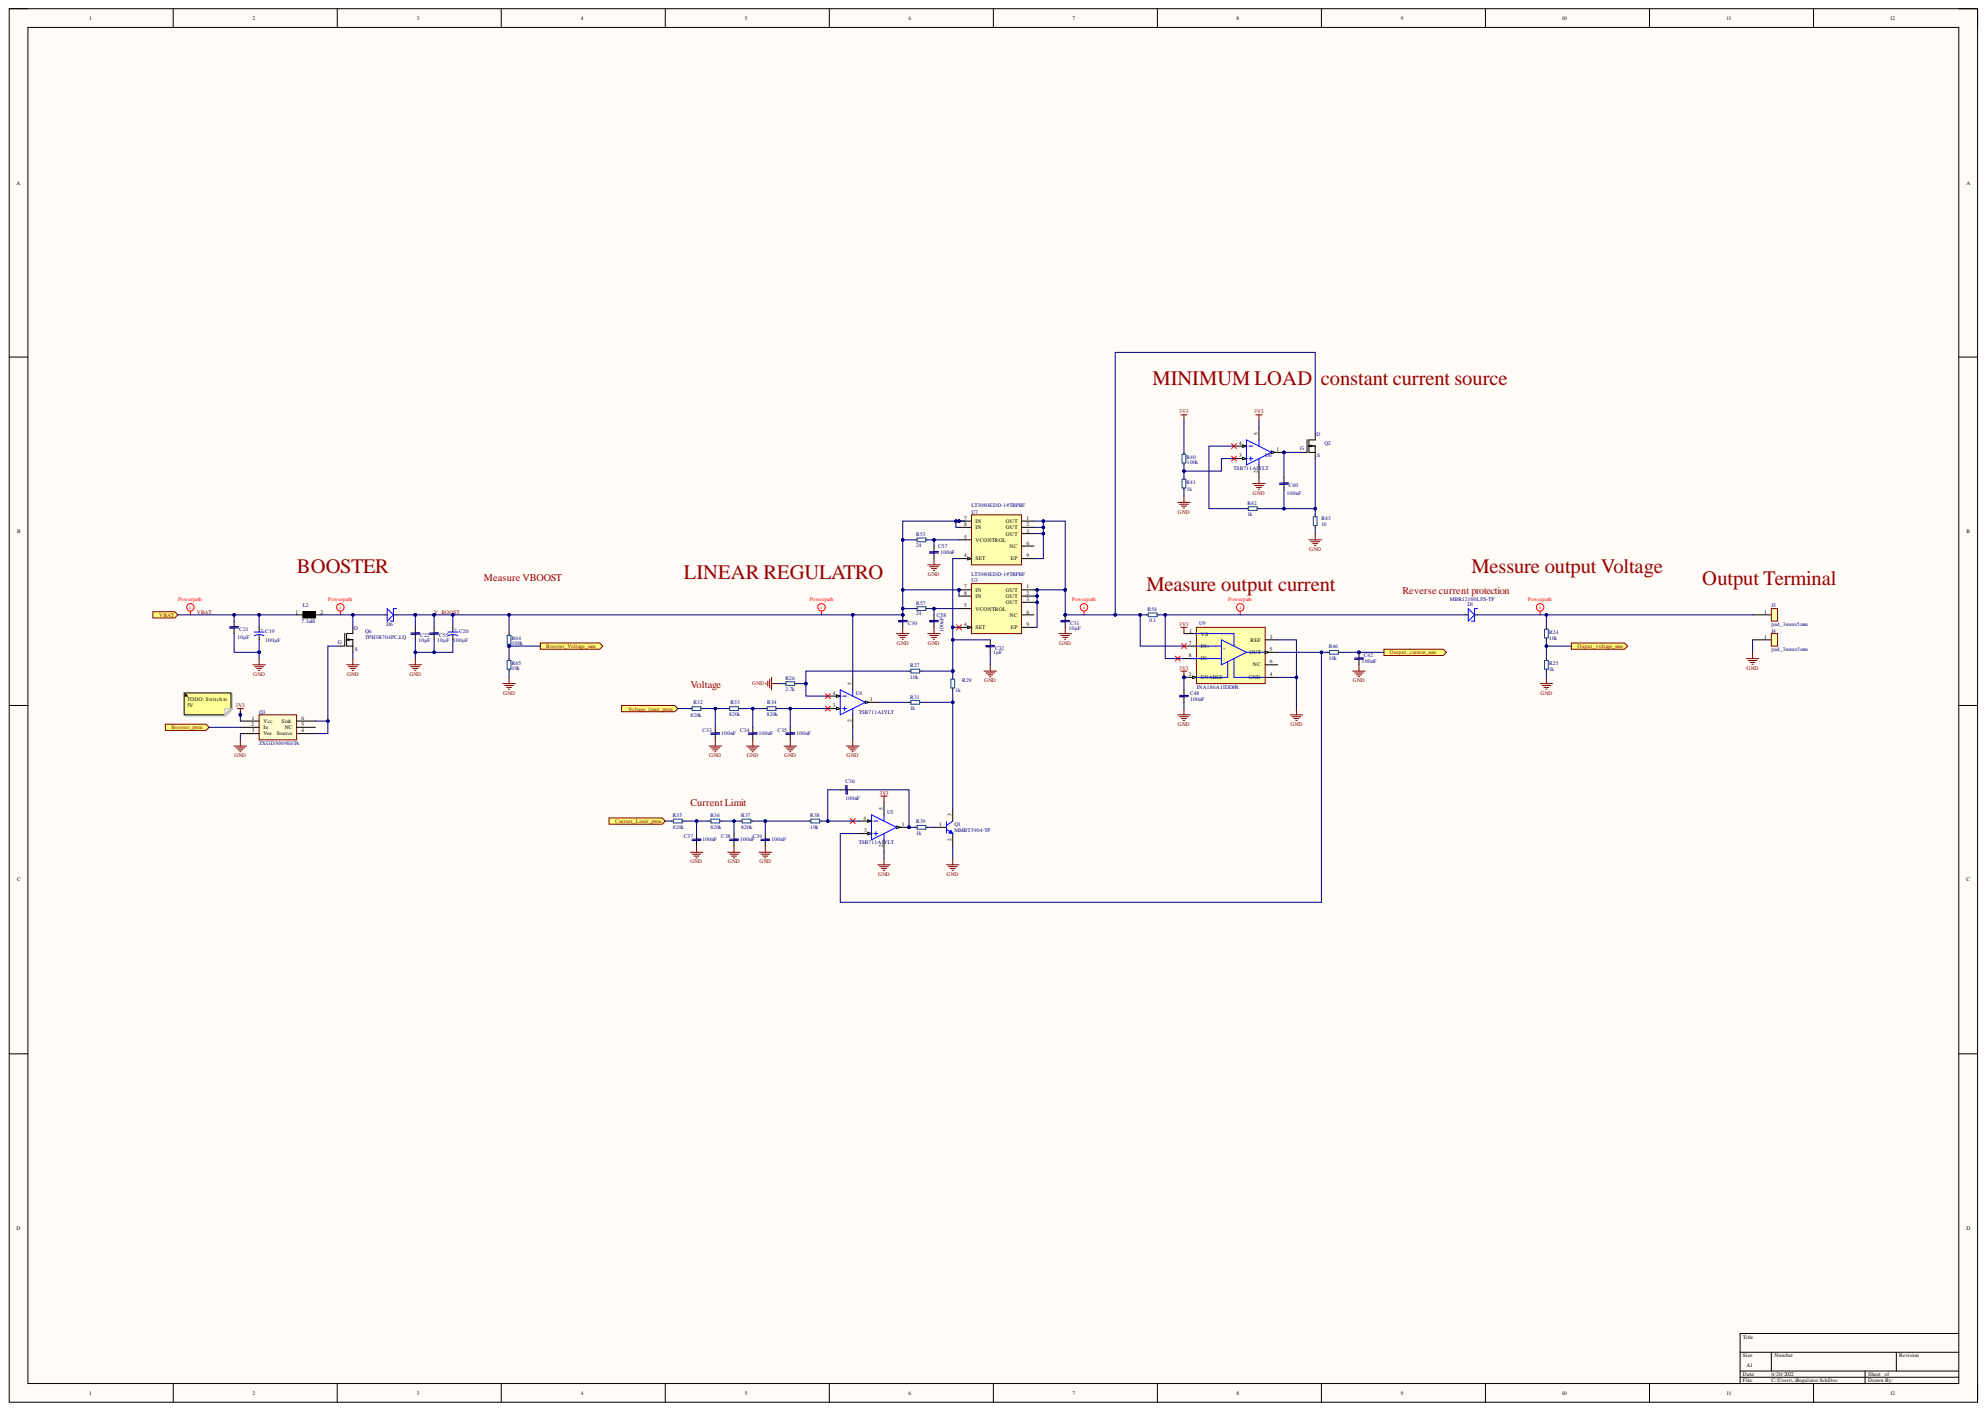
[picture p22: page 3]

8 5 | IN O U T IN O U T O U T VCO N TRO L N C SE T E P | 2 3 | Po werpath i
