Blue-Smoke-Electronics/Ember/pcb/Schematics/rev_8.pdf

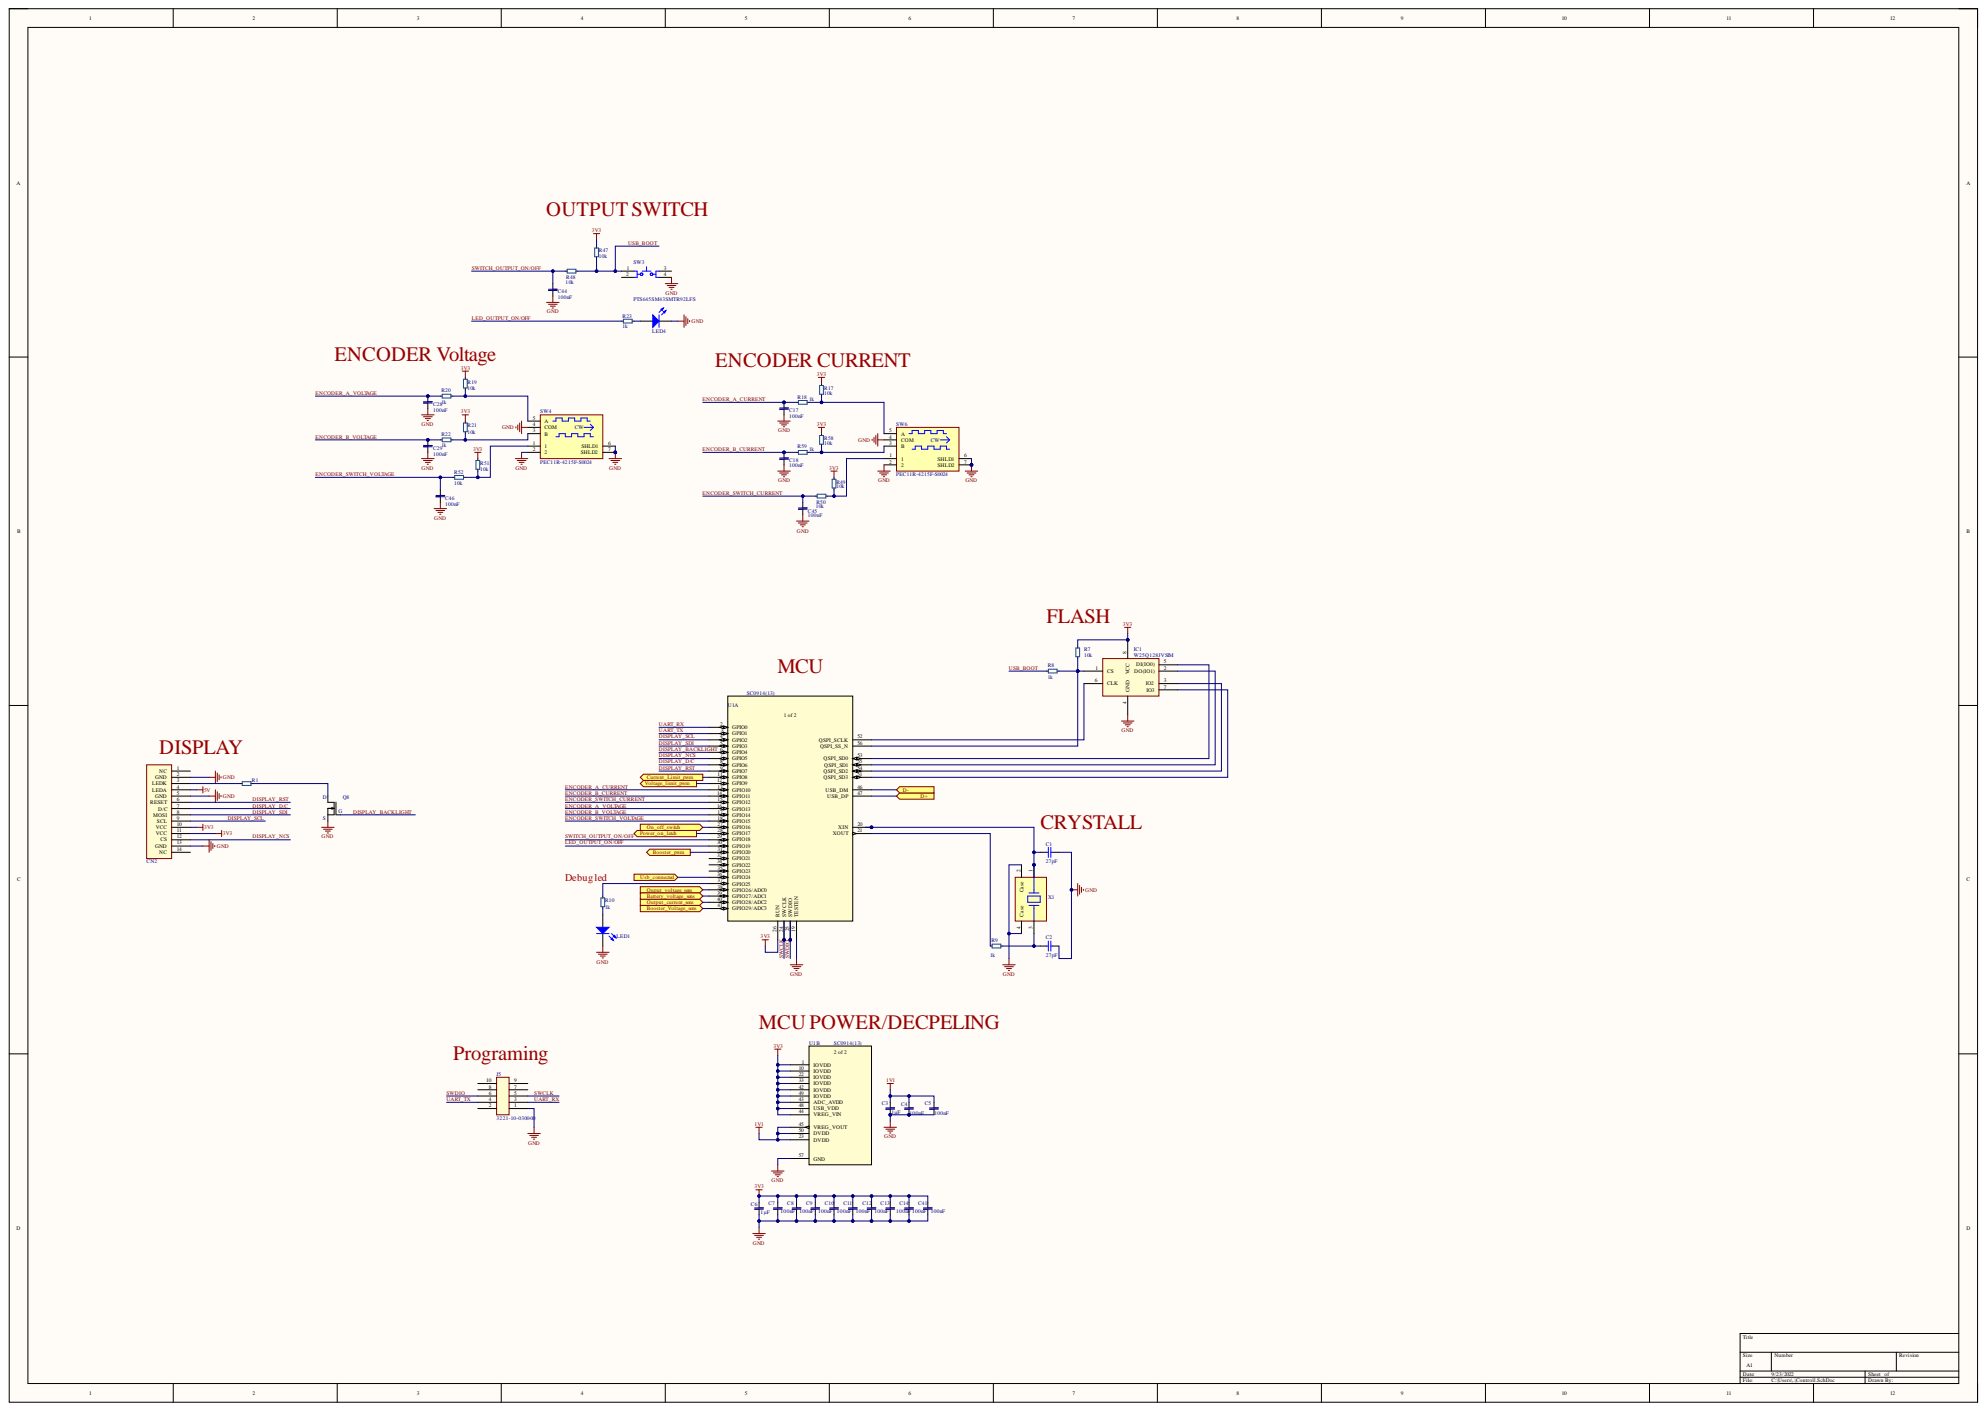
[picture p32: page 1]

USB_BOOT 1k | CS 1 DO(IO1) CLK 6 IO2 | 2 3

Ouput_voltage_sens | GPIO25 37 GPIO26/ADC0 38

IOVDD 49 ADC_AVDD 43

USB_VDD 48 VREG_VIN 44

DVDD 23 DVDD 50

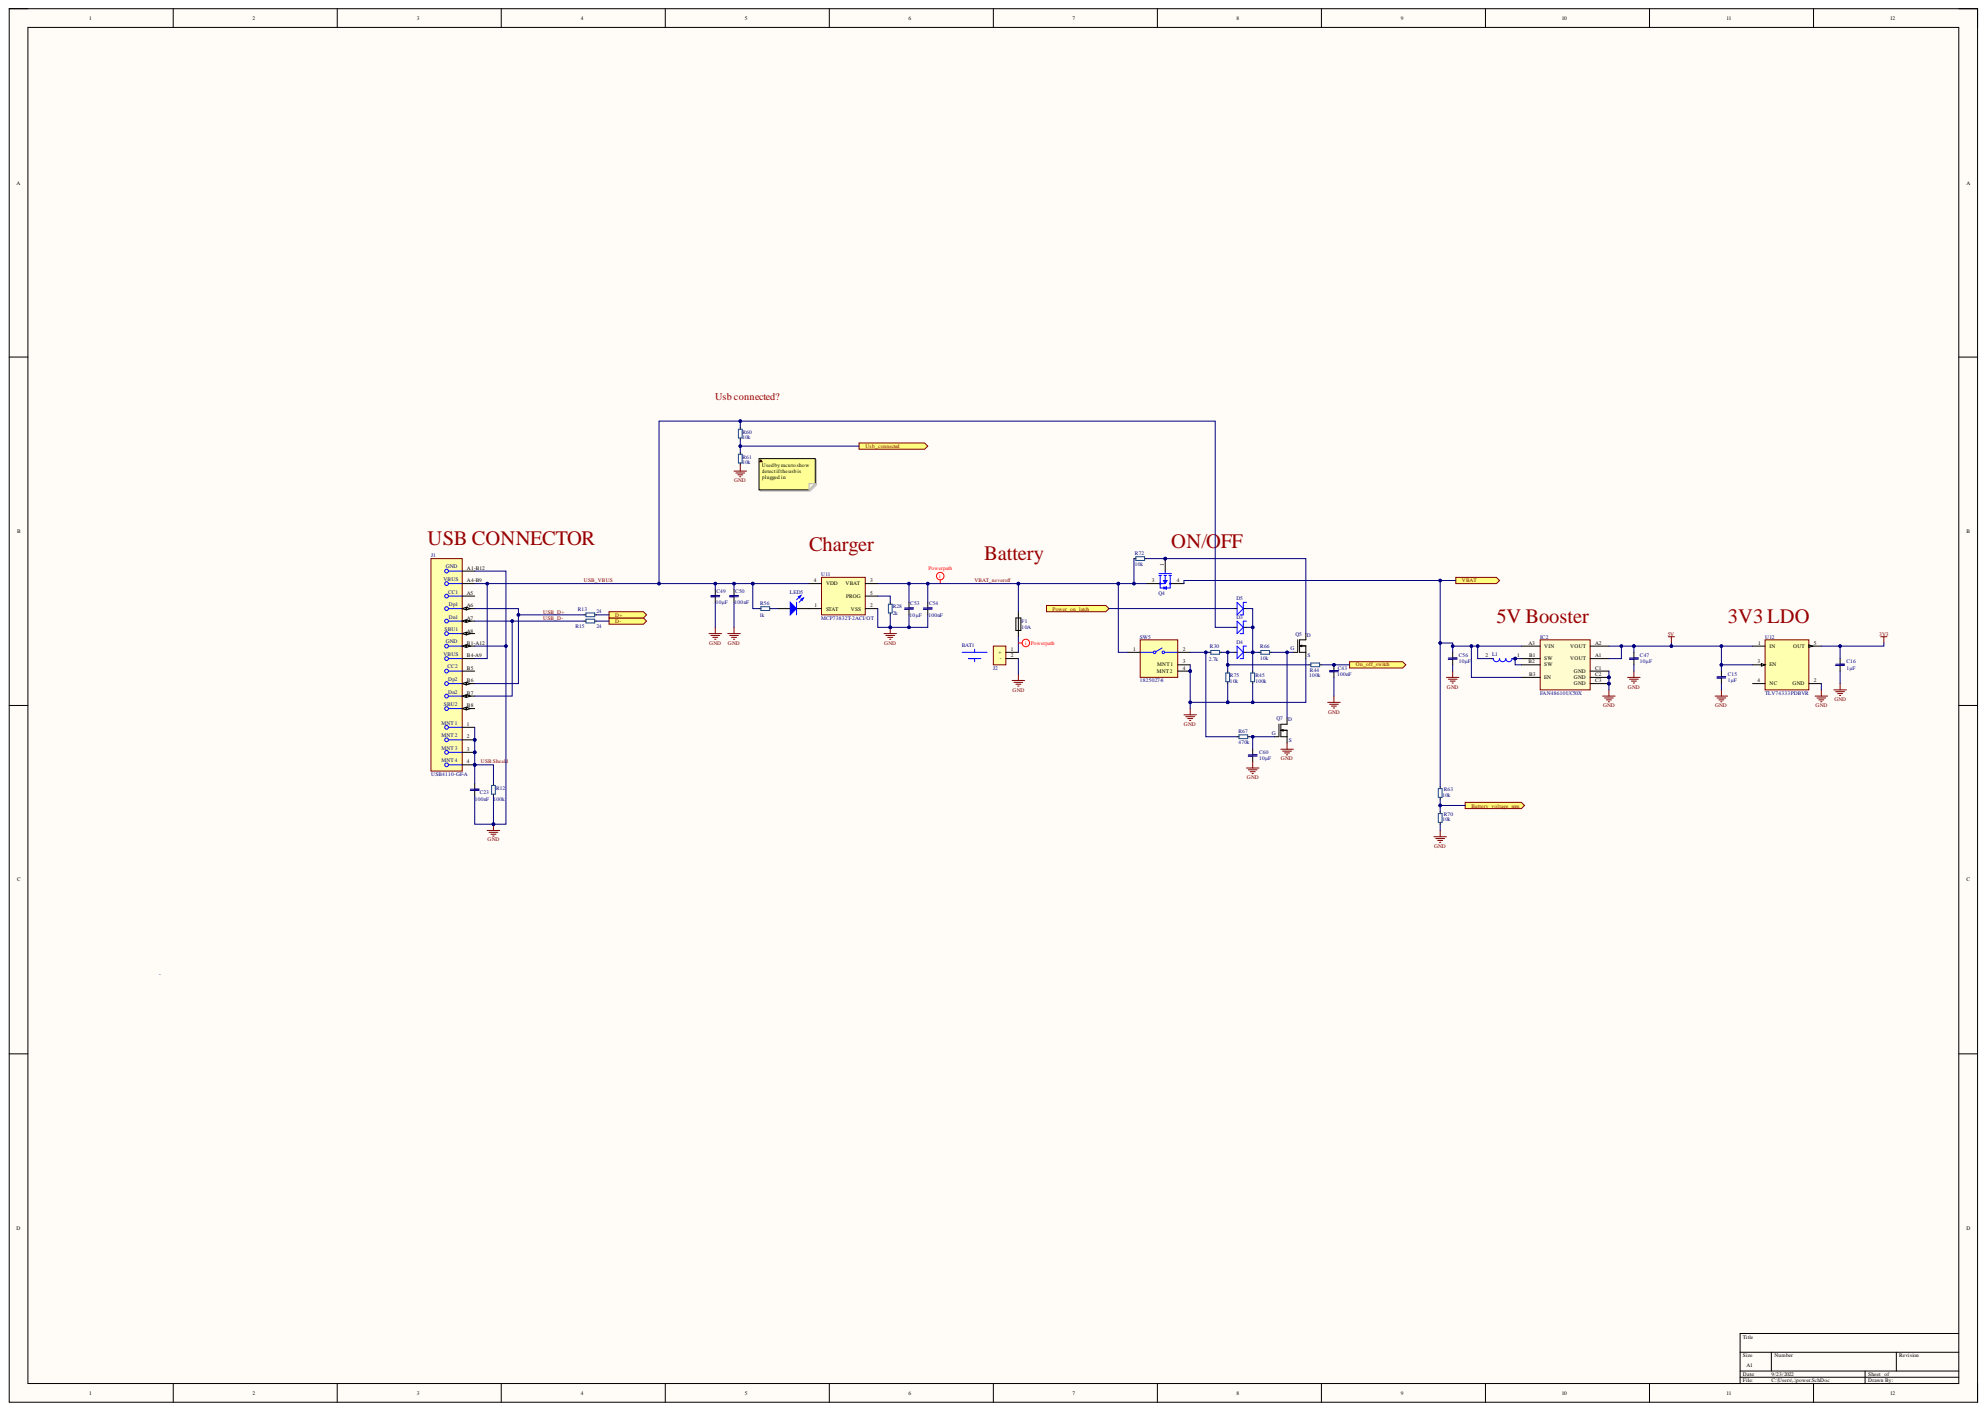
[picture p33: page 2]

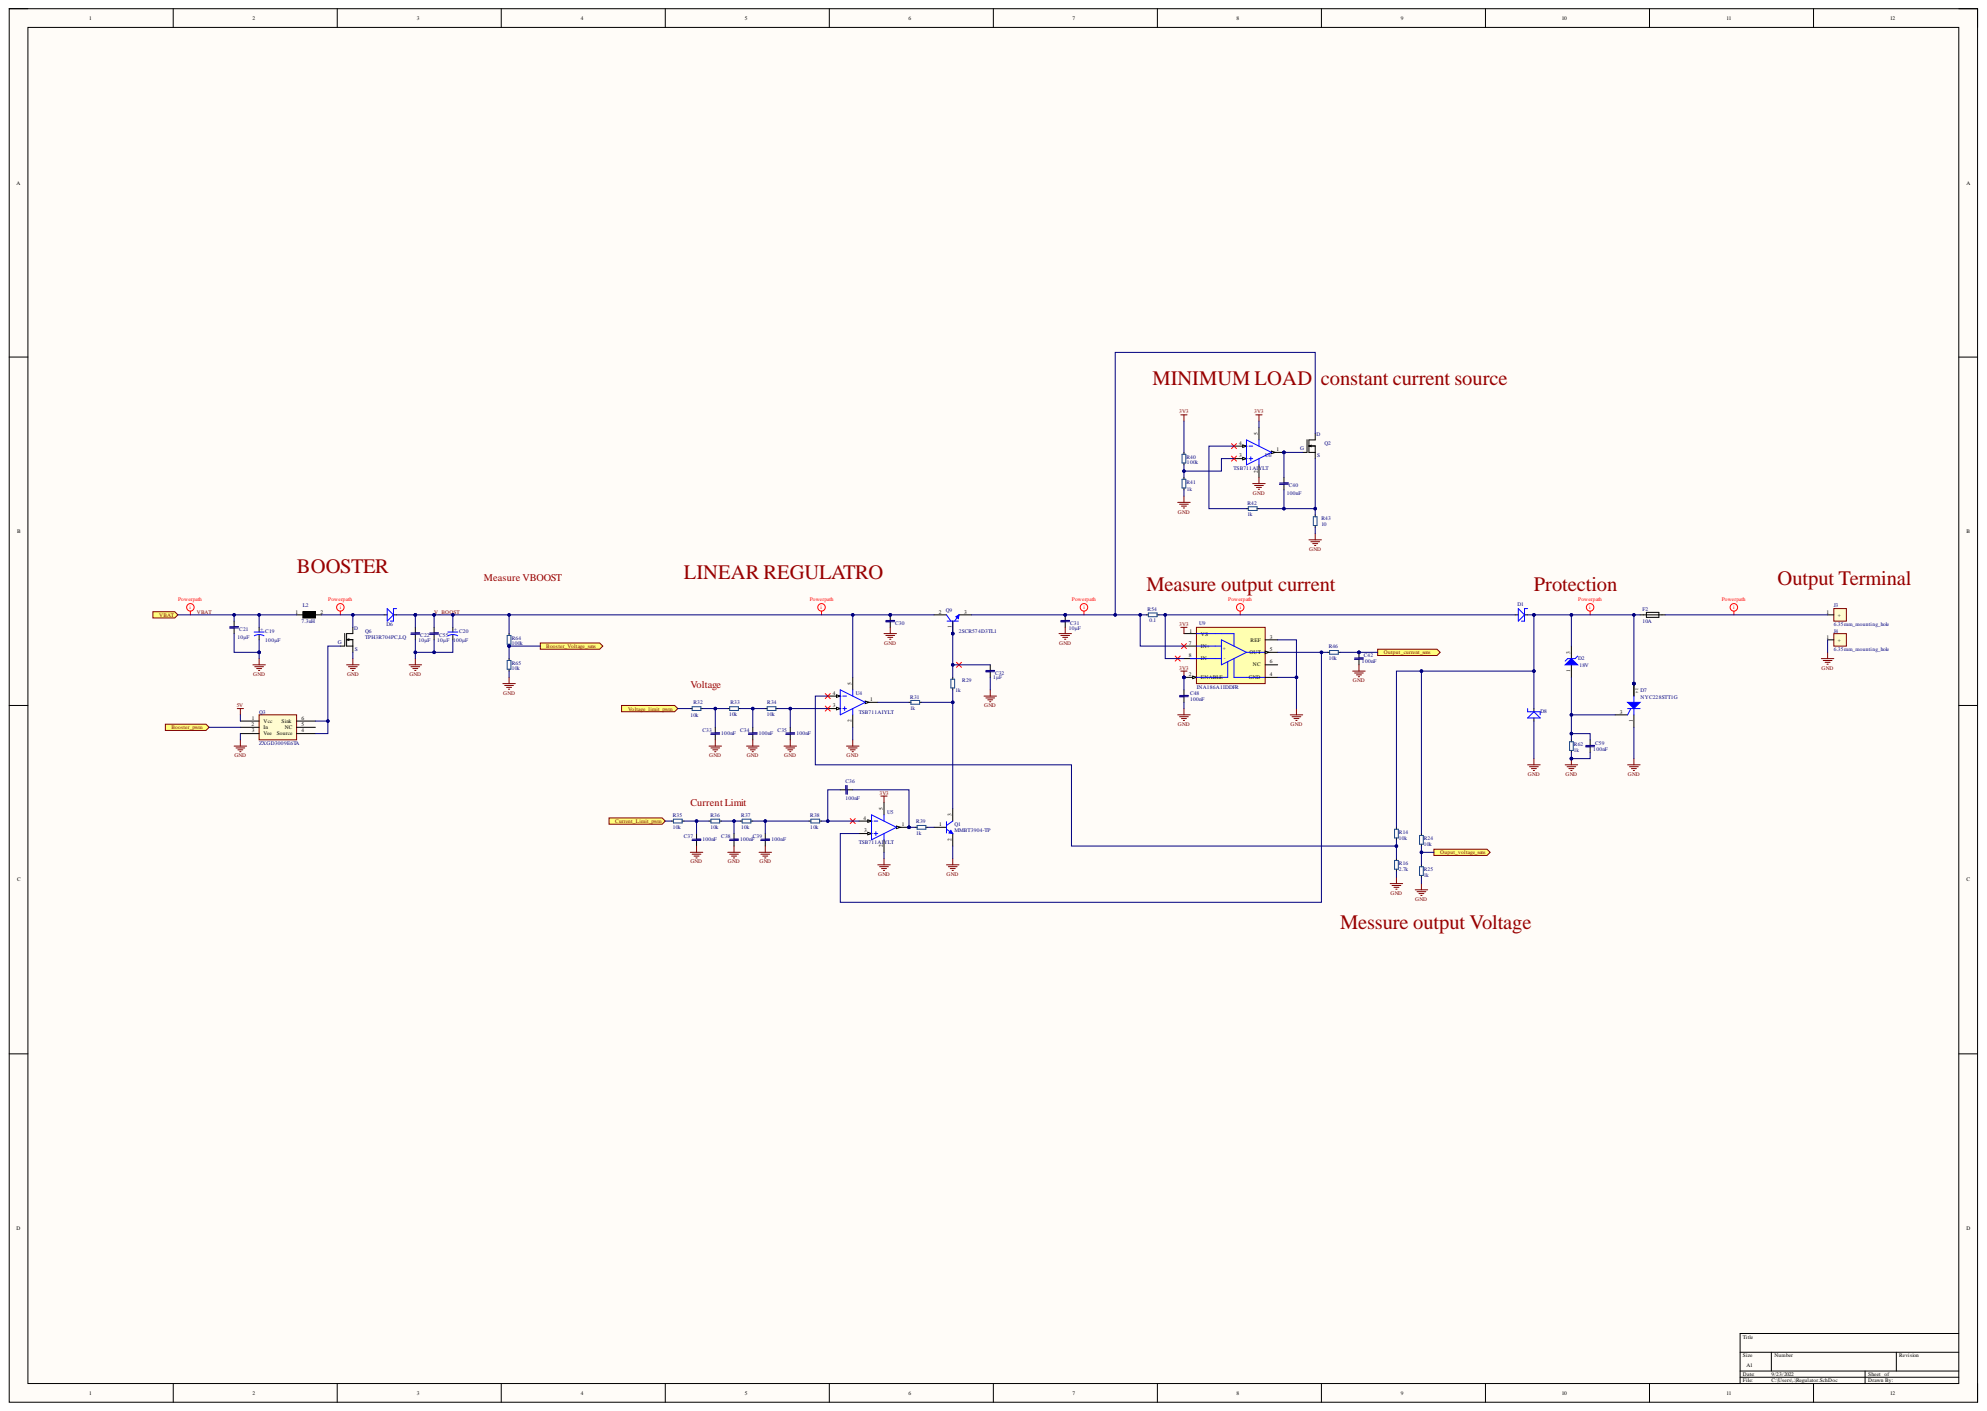
[picture p34: page 3]
