Blue-Smoke-Electronics/Ember/powersupply_firmware/Pico/src/Flash.cpp

#include "Flash.h"
#include <stdio.h>
#include "pico/stdlib.h"
#include "Pcb.h"
#include "hardware/sync.h"

#include "Font.h"

#include "smallFont.h"
#include "timeFont.h"
#include "bigFont.h"

#include "logo_text.h"
#include "logo_symbol.h"
#include "outputOnSymbol.h"      
#include "outputOffSymbol.h"
#include "batterySymbol.h"
#include "batterySymbol_bar.h"
#include "batteryUpArrow.h"
#include "batteryDownArrow.h"
#include "batteryChargingSymbol.h"
#include "chargingSymbol.h"
#include "selectedMarker.h"
#include "overheatSymbol.h"
 
uint8_t Flash::write_buffer[FLASH_PAGE_SIZE / sizeof(float)];

void Flash::Save(float batteryCapacity, float outputVoltage, float outputCurrent){
    write_buffer[0] = ((uint8_t*)(&batteryCapacity))[0];
    write_buffer[1] = ((uint8_t*)(&batteryCapacity))[1];
    write_buffer[2] = ((uint8_t*)(&batteryCapacity))[2];
    write_buffer[3] = ((uint8_t*)(&batteryCapacity))[3];
    write_buffer[4] = ((uint8_t*)(&outputVoltage))[0];
    write_buffer[5] = ((uint8_t*)(&outputVoltage))[1];
    write_buffer[6] = ((uint8_t*)(&outputVoltage))[2];
    write_buffer[7] = ((uint8_t*)(&outputVoltage))[3];
    write_buffer[8] = ((uint8_t*)(&outputCurrent))[0];
    write_buffer[9] = ((uint8_t*)(&outputCurrent))[1];
    write_buffer[10] = ((uint8_t*)(&outputCurrent))[2];
    write_buffer[11] = ((uint8_t*)(&outputCurrent))[3];
    sleep_ms(100); // magicaly removes freeses

    // writing to end of flash memmory
    uint32_t ints = save_and_disable_interrupts(); // todo disable dual core

    flash_range_erase(Pcb::flash_size_bytes-FLASH_SECTOR_SIZE, FLASH_SECTOR_SIZE);
    flash_range_program(Pcb::flash_size_bytes-FLASH_SECTOR_SIZE, write_buffer, FLASH_PAGE_SIZE);

    restore_interrupts (ints);
}

float Flash::GetBatteryCapacity(){
    return ((float *)(XIP_BASE+Pcb::flash_size_bytes - FLASH_SECTOR_SIZE))[0];
}

float Flash::GetOutputVoltage(){
    return ((float *)(XIP_BASE+Pcb::flash_size_bytes - FLASH_SECTOR_SIZE))[1];
}

float Flash::GetOutputCurrent(){
    return ((float *)(XIP_BASE+Pcb::flash_size_bytes - FLASH_SECTOR_SIZE))[2];
}

void Flash::SaveVoltageCalibrations(float* voltageCalibrations){
    uint32_t ints = save_and_disable_interrupts(); // todo disable dual core

    flash_range_erase(Pcb::flash_size_bytes-FLASH_SECTOR_SIZE*2, FLASH_SECTOR_SIZE);
    flash_range_program(Pcb::flash_size_bytes-FLASH_SECTOR_SIZE*2, (uint8_t*)voltageCalibrations, FLASH_PAGE_SIZE);

    restore_interrupts (ints);

}
void Flash::SaveCurrentCalibrations(float* currentCalibrations){
    uint32_t ints = save_and_disable_interrupts(); // todo disable dual core

    flash_range_erase(Pcb::flash_size_bytes-FLASH_SECTOR_SIZE*3, FLASH_SECTOR_SIZE);
    flash_range_program(Pcb::flash_size_bytes-FLASH_SECTOR_SIZE*3, (uint8_t*)currentCalibrations, FLASH_PAGE_SIZE);

    restore_interrupts (ints);
}

float * Flash::GetVoltageCalibrations(){
    return (float*)(XIP_BASE+Pcb::flash_size_bytes-FLASH_SECTOR_SIZE*2);
}
float * Flash::GetCurrentCalibrations(){
    return (float*)(XIP_BASE+Pcb::flash_size_bytes-FLASH_SECTOR_SIZE*3);
}


Font Flash::smallFont = Font(smallFont_CHARS, smallFont_SETUP, smallFont_DATA);
Font Flash::timeFont = Font(timeFont_CHARS, timeFont_SETUP, timeFont_DATA);
Font Flash::bigFont = Font(bigFont_CHARS, bigFont_SETUP, bigFont_DATA);

Sprite Flash::logo_text = Sprite(logo_text_SETUP, logo_text_DATA);
Sprite Flash::logo_symbol = Sprite(logo_symbol_SETUP, logo_symbol_DATA);
Sprite Flash::outputOnSymbol = Sprite(outputOnSymbol_SETUP, outputOnSymbol_DATA);
Sprite Flash::outputOffSymbol = Sprite(outputOffSymbol_SETUP, outputOffSymbol_DATA);
Sprite Flash::batterySymbol = Sprite(batterySymbol_SETUP, batterySymbol_DATA);
Sprite Flash::batterySymbol_bar = Sprite(batterySymbol_bar_SETUP, batterySymbol_bar_DATA);
Sprite Flash::batteryUpArrow = Sprite(batteryUpArrow_SETUP, batteryUpArrow_DATA);
Sprite Flash::batteryDownArrow = Sprite(batteryDownArrow_SETUP, batteryDownArrow_DATA);
Sprite Flash::batteryChargingSymbol = Sprite(batteryChargingSymbol_SETUP, batteryChargingSymbol_DATA);
Sprite Flash::chargingSymbol = Sprite(chargingSymbol_SETUP, chargingSymbol_DATA);
Sprite Flash::selectedMarker = Sprite(selectedMarker_SETUP, selectedMarker_DATA);
Sprite Flash::overheatSymbol = Sprite(overheatSymbol_SETUP, overheatSymbol_DATA);
