Blue-Smoke-Electronics/Ember/powersupply_firmware/Pico/src/Battery.cpp

#include "Battery.h"
#include "Analog.h"
#include "Flash.h"
#include "PSU.h"
#include "Pcb.h"
#include "Booster.h"
#include "LinReg.h"
#include "Onoff.h"


const float Battery::maxCapacity = 0.8*1950 * 3.6 * 3600; //mWs


const uint32_t Battery::update_freq_us = 2 * 1000 * 1000;
uint32_t Battery::update_timer;

float Battery::capasityLeft = 0;

void Battery::Init(){
    Analog::Init();
    gpio_init(Pcb::usb_connected_pin);
    gpio_set_dir(Pcb::usb_connected_pin,GPIO_IN);


    capasityLeft = Flash::GetBatteryCapacity();
}

void Battery::Update(){
    if(time_us_32() - update_timer > update_freq_us)
    {   
        uint32_t delta_t = time_us_32() - update_timer;

        update_timer = time_us_32();

        capasityLeft -= delta_t/1000000.0f *  GetTotalPowerDraw();

        // correct from messurment 
        capasityLeft += (EstimateCapacityByVoltage()-capasityLeft )*0.0005;
        
        if(capasityLeft > maxCapacity)
            capasityLeft = maxCapacity;



        if (GetVoltage() < 3.0f || capasityLeft < 0){  
            capasityLeft = 0;
            PSU::Disable();
        }


        if (GetVoltage() < 2.85f){
            capasityLeft = 0;
            Onoff::Emergency_power_off();
            
            
        }
    }
}  

float Battery::GetQuiescentPower(){
    //unit is mW
    return 300; // measured values, avrage over different battery voltages
}

float Battery::GetPsuQuiescentPower(){
    //unit is mW
    return 10 * PSU::getVoltage(); // mostly do to minimum current draw circuit
}

























float Battery::GetChargingPower(){
    //unit is mW
    return 5 * 450;
}

bool Battery::IsChargerConnected(){
    return gpio_get(Pcb::usb_connected_pin);
}

bool Battery::IsCharging(){
    return GetTotalPowerDraw() <= 0;
}

bool Battery::GetChargerStatus(){
    return !gpio_get(Pcb::usb_connected_pin);
}

float Battery::GetTotalPowerDraw(){
    float totalpower = 0;
    
    totalpower += GetQuiescentPower();
    if(PSU::IsEnabled()){
        float linRegLosses = (Booster::GetVoltage() - LinReg::GetVoltage()) * LinReg::GetCurrent();
        float boosterLosses = PSU::getPower()* 1000 * 0.4; 
        totalpower += PSU::getPower() * 1000 + linRegLosses + boosterLosses;
    }

    if(IsChargerConnected())
        totalpower -= GetChargingPower();

    return totalpower; // unit is mW // negativ if device is charging
}

float Battery::GetVoltage(){
    return Analog::GetBatteryVoltage();
}

float Battery::GetBatteryLife_s(){
    int lifetime=0;
    float powerdraw = GetTotalPowerDraw();
    if(powerdraw < 0)
       lifetime= (maxCapacity - GetCapasityLeft()) / (-powerdraw);
    else
        lifetime = GetCapasityLeft()/powerdraw; 

    if (lifetime > 172800) // cap at 48 houers
        lifetime = 172800;

    if (lifetime < 0)
        lifetime =0;

    return lifetime; 
}

float Battery::GetBatteryProcentage(){
    return (GetCapasityLeft() / maxCapacity) * 100.0f;
}

float Battery::GetCapasityLeft(){
    return capasityLeft;
}

float Battery::EstimateCapacityByVoltage(){
    
    float currentdraw = GetTotalPowerDraw()/GetVoltage();
    if(currentdraw < 0){
        currentdraw =0; 
    }
    float voltagedrop = currentdraw/1000 * 0.130; //internal resistance of 50mohm
    float noloadvoltage = GetVoltage() + voltagedrop; 

    float V_full = 4.1; 
    float V_empty = 3.4; 

    float a = maxCapacity/(V_full-V_empty);
    float b = maxCapacity-a*V_full; 

    float capleft = a*noloadvoltage + b; //12857*noloadvoltage*3600 - 43714*3600; // linear regression of discharge curv
    if (capleft< 0){
        capleft =0; 
    }
    if(capleft > maxCapacity){
        capleft = maxCapacity;
    }
    return capleft;
}
