Blue-Smoke-Electronics/Ember/powersupply_firmware/Pico/src/Heartbeat.cpp

#include "Heartbeat.h"
#include "pico/stdlib.h"
#include <stdio.h>
#include "Pcb.h"    

Heartbeat::Heartbeat(){
//    TaskHandle_t heartbeat_Task = NULL;
//    uint32_t s1 = xTaskCreate(Hartbeat_task, "Heartbeat", 1024, NULL, 0, &heartbeat_Task);
    gpio_init(Pcb::debbug_led_pin);
    gpio_set_dir(Pcb::debbug_led_pin, GPIO_OUT);
    gpio_put(Pcb::debbug_led_pin, true);
    led_value = 0;
    update_timer = time_us_32();
}

void Heartbeat::Update(){
    if(time_us_32() - update_timer > update_freq_us)
    {
        update_timer = time_us_32();
        gpio_put(Pcb::debbug_led_pin, led_value);
        led_value = !led_value;
    }
}
