Blue-Smoke-Electronics/Ember/(commit log)

2022-02-09 added projects files from bitbucker repo
    [Battery.ipt, Bottom_lid.ipt, Bottom_lid.stl, Display.ipt, Encoder knob.ipt, Frontpanel.ipt, Frontpanel.stl, LOGO.ipt]
2022-02-09 added powersupply files
2022-02-09 added altium files
    [Booster.SchDoc, Controll.SchDoc, Display.SchDoc, Driver.SchDoc, LDO.SchDoc, Min_load_constan_current.SchDoc, Powersupply.PrjPcb, Voltage_limiter.SchDoc]
2022-02-09 redone battery setup
    [current_sens.SchDoc]
2022-02-14 test altum save to server
    [Controll.SchDoc, Powersupply.PrjPcb, battery_charger.SchDoc, mcu.SchDoc, on_off.SchDoc, power.SchDoc, top.SchDoc]
2022-02-14 removerd validation errors
    [Controll.SchDoc, Display.SchDoc, Min_load_constan_current.SchDoc, Powersupply.PrjPcb, battery_charger.SchDoc, charging_booster.SchDoc, current_sens.SchDoc, mcu.SchDoc]
2022-02-14 updated desing rules for jlcpcb
    [Controll.SchDoc, power.SchDoc]
2022-02-14 started updated routing
    [Display.SchDoc, on_off.SchDoc, power.SchDoc]
2022-02-16 changed battery connector- started on rerouting
    [Controll.SchDoc, Display.SchDoc, Driver.SchDoc, LDO.SchDoc, Min_load_constan_current.SchDoc, Powersupply.PrjPcb, bat_voltage_sens.SchDoc, battery_charger.SchDoc]
2022-02-21 started adding testpoints with testpoint manager
    [Controll.SchDoc, Display.SchDoc, Driver.SchDoc, Powersupply.PrjPcb, battery_charger.SchDoc, buckReg.SchDoc, current_sens.SchDoc, knobs.SchDoc]
2022-02-23 drc passed
    [Driver.SchDoc, top.SchDoc, usb.SchDoc]
2022-02-23 updated 3d outline layer
    [2022-02-23.GBL, 2022-02-23.GBO, 2022-02-23.GBP, 2022-02-23.GBS, 2022-02-23.GM1, 2022-02-23.GTL, 2022-02-23.GTO, 2022-02-23.GTP]
2022-02-23 sendt to production
    [2022-02-23.GBL, 2022-02-23.GBO, 2022-02-23.GBP, 2022-02-23.GBS, 2022-02-23.GM1, 2022-02-23.GTL, 2022-02-23.GTO, 2022-02-23.GTP]
2022-02-23 added rev 5 gerber files
2022-02-28 Update battery.c
    added comments
2022-03-03 classes for devices added
2022-03-09 removed uart lock form random tester
2022-03-17 smal updates during assembly
    [buckReg.SchDoc, on_off.SchDoc]
2022-04-02 started testing pico as new mcu. display can show images
2022-04-03 started work on rev 6 - Pico edition
    [Booster.SchDoc, Controll.SchDoc, Display.SchDoc, Driver.SchDoc, Powersupply.PrjPcb, bat_voltage_sens.SchDoc, battery_charger.SchDoc, mcu.SchDoc]
2022-04-04 pico connected up
    [LDO.SchDoc, knobs.SchDoc, mcu.SchDoc, programmer.SchDoc]
2022-04-04 mostly done with update to pico
    [Booster.SchDoc, Controll.SchDoc, Driver.SchDoc, bat_voltage_sens.SchDoc, battery_charger.SchDoc, knobs.SchDoc, mcu.SchDoc, power.SchDoc]
2022-04-04 errors removed
    [Booster.SchDoc, Controll.SchDoc, Display.SchDoc, Driver.SchDoc, LDO.SchDoc, Powersupply.PrjPcb, bat_voltage_sens.SchDoc, battery_charger.SchDoc]
2022-04-04 in midel of fixing issues form github projecst
    [Powersupply.PrjPcb, battery_charger.SchDoc, on_off.SchDoc, power.SchDoc, usb_isolator.SchDoc]
2022-04-06 almost doner routing
    [knobs.SchDoc, linear_regulator.SchDoc, mcu.SchDoc]
2022-04-07 pcb send to production
    [buckReg.SchDoc]
2022-04-14 dma to spi working
2022-04-27 fixed debounce on on/off switch and added hartbeat class
    [GUI.h, Hartbeat.cpp, Hartbeat.h, Onoff.cpp, Onoff.h, main.cpp]
2022-05-02 printing strings on display works
2022-05-05 linreg regulator working implemented
2022-05-08 encoders working
2022-05-08 saving volate an currage to flash works. started implementing battery controller
2022-05-27 3d model fitting together
    [Bottom_lid.ipt, Bottom_lid.stl, Display.ipt, Frontpanel.ipt, Frontpanel.stl, LOGO.ipt, ON_Off_switch.ipt, Powersupply.PrjPcb]
2022-05-27 started testion og psu. Problems with linreg heating
    [linear_regulator.SchDoc]
2022-06-05 started updating errors form rev 6
    [Booster.SchDoc, LDO.SchDoc, Powersupply.PrjPcb, battery_charger.SchDoc, linear_regulator.SchDoc, on_off.SchDoc, programmer.SchDoc]
2022-06-07 started working on better enclousure solution
    [Battery.ipt, Bottom_lid.ipt, Display.ipt, Frontpanel.ipt, display_holder.ipt, power_button.ipt]
2022-06-09 components are more ore less in the right place
    [Booster.SchDoc, Controll.SchDoc, Display.SchDoc, Driver.SchDoc, Powersupply.PrjPcb, battery_charger.SchDoc, current_sens.SchDoc, linear_regulator.SchDoc]
2022-06-09 Mid routing
    [Booster.SchDoc, Display.SchDoc]
2022-06-09 battery holder is part of backplate
    [Bottom_lid.ipt, Display.ipt, Frontpanel.ipt, battery_holder.ipt, display_holder.ipt, m1_4_10mm_screw.ipt, m1_4_6mm_screw.ipt]
2022-06-12 layout almost done
    [LDO.SchDoc, linear_regulator.SchDoc, on_off.SchDoc]
2022-06-13 passing drc
    [linear_regulator.SchDoc]
2022-06-13 added lcsc partnumbers
    [Booster.SchDoc, Display.SchDoc, Driver.SchDoc, LDO.SchDoc, Min_load_constan_current.SchDoc, bat_voltage_sens.SchDoc, battery_charger.SchDoc, current_sens.SchDoc]
2022-06-14 generated shematics
    [Bottom_lid.stl, Display.ipt, Frontpanel.ipt, Frontpanel.stl, display_holder.ipt, display_holder.stl]
2022-06-19 fixed anotation
    [Booster.SchDoc, Controll.SchDoc, Display.SchDoc, Driver.SchDoc, LDO.SchDoc, Min_load_constan_current.SchDoc, Powersupply.PrjPcb, bat_voltage_sens.SchDoc]
2022-06-19 almost done reworking schematics
    [Controll.SchDoc, Powersupply.PrjPcb, power.SchDoc, top.SchDoc]
2022-06-20 removed all hyrarcy
    [Controll.SchDoc, Powersupply.PrjPcb, Regulator.SchDoc, power.SchDoc, top.SchDoc]
2022-06-20 generated new schematic pdf
    [Controll.SchDoc, Regulator.SchDoc, power.SchDoc]
2022-06-20 removed boxes
    [Controll.SchDoc, Powersupply.PrjPcb, Regulator.SchDoc, power.SchDoc]
2022-06-20 generated pdf
    [Controll.SchDoc]
2022-06-21 added protection circuit to schematic
    [Powersupply.PrjPcb, Regulator.SchDoc, power.SchDoc]
2022-06-21 added protection cricuit
    [Regulator.SchDoc, power.SchDoc]
2022-07-07 fixed hold in power button error
    [encoder_knob_custom.stl, power.SchDoc, power_button.stl]
2022-08-11 fixed on off button debounce. added usb only charging screen
    [GUI.cpp, Knobs.cpp, Knobs.h, Onoff.cpp, Onoff.h, main.cpp]
2022-08-17 hot fix on freesing problem
    [Battery.cpp, Display.cpp, Display.h, Flash.cpp, Onoff.cpp, main.cpp]
2022-08-29 fixed delay error in display
    [Display.cpp, Display.h, GUI.cpp]
2022-08-29 removed inventor files from repo. Added .stl 3d models
    [Battery.ipt, Bottom_lid.ipt, Bottom_lid.stl, Display.ipt, Encoder knob.ipt, Frontpanel.ipt, Frontpanel.stl, LOGO.ipt]
2022-08-29 removed altium files.
    [2022-02-23.GBL, 2022-02-23.GBO, 2022-02-23.GBP, 2022-02-23.GBS, 2022-02-23.GM1, 2022-02-23.GTL, 2022-02-23.GTO, 2022-02-23.GTP]
2022-08-29 renamed gerber
2022-08-30 small display hole in front panel
    [Frontpanel.stl]
2022-09-08 working on display and battery placement
    [Frontpanel.stl, battery_holder.stl, button.stl, button_round.ipt, display_holder.stl]
2022-09-19 fixed hartbit H typo, reduced battery capacyty
    [Battery.cpp, Hartbeat.cpp]
2022-09-23 Display do no longer have a linked list
    [Display.cpp, Display.h, GUI.cpp]
2022-09-23 added production files
    [bom_rev7.csv, bom_rev_8.csv]
2022-09-27 images now live in .h files in, they are not uploaded through uart
2022-10-06 removed unused file, added backlight controll
    [Bottom_lid.stl, Frontpanel.stl, display_holder.stl]
2022-10-13 implemented battery test
2022-10-13 increased size to allow for bigger battery
    [Bottom_lid.stl, Frontpanel.stl, battery_holder.stl]
2022-10-13 tryied implementing battery dimming, did not work pga hardware error
    [Battery.cpp, Display.cpp, Display.h, main.cpp]
2022-10-15 Battery.h: delete some whitespace
2022-10-15 Knobs.h: fix some whitespace
    [Knobs.h]
2022-10-15 LinReg.h: fix some whitespace
    [LinReg.h]
2022-10-15 OnOff.h: fix some whitespace
    [Onoff.h]
2022-10-15 PSU.h: fix some whitespace
    [PSU.h]
2022-10-15 Pcb.h: delete a couple of newlines
2022-10-15 Analog.cpp: fix some whitespace
    [Analog.cpp]
2022-10-15 Battery.cpp: fix some whitespace
    [Battery.cpp]
2022-10-15 Booster.cpp: fix some whitespace
    [Booster.cpp]
2022-10-15 CommandLineInterface.cpp: fix some whitespace
    [CommandLineInterface.cpp]
2022-10-15 Display.cpp: fix some whitespace
    [Display.cpp]
2022-10-15 Flash.cpp: fix some whitespace
    [Flash.cpp]
2022-10-15 GUI.cpp: fix some whitespace
    [GUI.cpp]
2022-10-15 Heartbeat.cpp: fix some whitespace
    [Heartbeat.cpp]
2022-10-15 Knobs.cpp: fix some whitespace
    [Knobs.cpp]
2022-10-15 LinReg.cpp: fix some whitespace
    [LinReg.cpp]
2022-10-15 OnOff.cpp: fix some whitespace
    [Onoff.cpp]
2022-10-15 PSU.cpp: fix some whitespace
    [PSU.cpp]
2022-10-15 Sprite.cpp: fix some whitespace
    [Sprite.cpp]
2022-10-15 main.cpp: fix some whitespace
    [main.cpp]
2022-10-18 Battery: Rename Quisent -> Quiescent
2022-10-18 moved battery power graphics
2022-10-21 smal changes to bottons
    [Bottom_lid.stl, button.stl, button_round.ipt, power_button.stl]
2022-10-21 fixed adc offsett
2022-10-24 battery symbol has arrows
2022-10-27 battery symbol tweeking
2022-10-28 Charging state is now saved when shutting down form charging mode.
2022-11-04 fixed encoder skipping due to debonce.
    [Knobs.cpp, LinReg.cpp]
2022-11-04 front pannel that do not trap binding posts turing dissassembely
    [Frontpanel.stl]
2022-11-07 booster power estimation was off by 1000.
2022-11-07 recharging voltage levels are compleatly wrong.
    [Battery.cpp]
2022-11-25 rev 9 sendt to production
    [Frontpanel.stl, bom_rev_9.csv]
2022-11-29 messurment Zero callibrating when powering on device
2022-11-29 encoder knob large edges
    [encoder_knob_custom.stl]
2022-11-29 smaler center encoder knobs
    [encoder_knob_custom.stl]
2022-12-01 new encoder 3d print
    [encoder_knob_custom.stl]
2022-12-01 battery test now have live plot
2022-12-01 comandline infterface starts up device
2022-12-01 Gui does not show empty before battery voltage is belove 3.0V, this allows for battery size to be larger than estimeted witout beeing turned off.
2022-12-01 changed scaling on x axis in plot
2023-01-03 updated rev9 stl, fixed baclight pinout
    [Bottom_lid.stl, Frontpanel.stl]
2023-01-03 added rev 10 production files
    [bom_rev_10.csv]
2023-01-03 moved file to right project
    [button_round.ipt]
2023-01-16 hot fix that solves prblem with non linearity in pico adc
    [Analog.cpp]
2023-01-17 tweeked booster voltage
2023-01-19 generated stl files
    [Bottom_lid.stl, Frontpanel.stl, battery_holder.stl, button.stl, button_round.stl, display_holder.stl, encoder_knob_custom.stl]
2023-01-20 re-enabled battery check
2023-01-20 fixed encoder flipp
2023-01-20 fixed encode only tirger on rising flank.
    [Knobs.cpp]
2023-01-24 Estimating battery life based on discharge curve for battery, not integration off powerusage
2023-01-27 updated .stl; buttons
    [Frontpanel.stl, encoder_knob_custom.stl, power_button.stl]
2023-01-27 updated battery capaciy estimation
2023-01-27 debuged booster slow turnon, fix now working without using mosfet driver IC
    [Booster.cpp, LinReg.cpp]
2023-01-27 changed output sens resistor devider to 2k+10K
2023-02-14 updated production files
    [bom_rev_11.csv, bom_rev_7.csv]
2023-02-14 removed unused pin
2023-02-14 updated 3d models
    [Bottom_lid.stl, Bottom_lid_no_ears.stl, Frontpanel.stl, Frontpanel_no_ears.stl, button_round.stl, power_button.stl]
2023-02-19 updated stl files
    [Bottom_lid.stl, Frontpanel.stl, display_holder.stl]
2023-02-27 reduced gap between encoder knob and frontpanel
    [encoder_knob_custom.stl]
2023-02-27 added temperature messurment in discharg testing.
2023-02-28 updated battery capacity
2023-02-28 fixed capacity error
2023-03-03 improvved battery estimation
2023-03-14 changed backlid for 22 mm screws
    [Bottom_lid.stl]
2023-03-30 added cover
    [Cover.stl, Cover_rev7_8_9.stl]
2023-04-13 added automatic poweroff and diming off display
2023-04-14 fixed battery bar so that 0 bars is 0% and only 100% gives 5 bars
    [GUI.cpp]
2023-04-17 updated to work wint 18V booster circuit
2023-06-12 working on geting 18V booster to work, saving to eprom doesn't work
    [Frontpanel_no_ears.stl]
2023-06-12 fixed flash error doe to sdk flash size
    [Flash.cpp, Flash.h, Pcb.h]
2023-06-20 implemented lowpas filter on displays, also implemented calibration from terminal
2023-06-23 device turnes on when pressing the on off button, not releasing it.
2023-06-30 implemented constant current indicator
    [Frontpanel_no_ears.stl]
2023-07-24 updated battery tresholds
2023-08-03 the small boosters 4.5V and 19.2V now has the enable signal connected to the mcu. This makes it positble to disable the booster when the battery level is very low.,
2023-08-04 fixed emerency power off
    [Onoff.cpp, Onoff.h, Powersaver.cpp]
2023-09-27 comitting before starting rev 14
    [Frontpanel_no_ears.stl, display_holder.stl]
2023-10-11 enabled debug led, moved small booster pin
    [Frontpanel_no_ears.stl]
